fkoran/fkoran.github.io/README.md

# [fkoran.github.io](https://fkoran.github.io/)
