fkoran/fkoran.github.io/_posts/2016-09-06-ergodox.markdown

---
layout: post
title: Ergodox Build
---

{::comment}
Need photos for:
- keyswitch layout inc. edges with ambiguous orientation
- finished product
- shot of the tools
- pcb, layer 3, and switches alone
- format tables, generate small images
{:/comment}

{::comment}
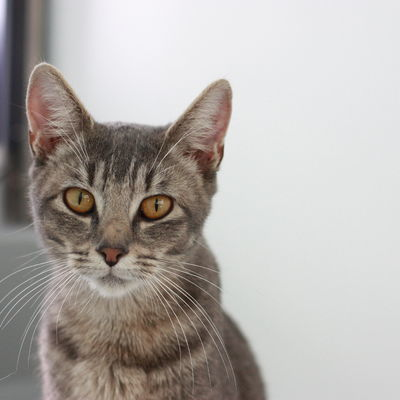
[picture p1: images/ergodox/beauty_small.jpg]
[](/images/ergodox/beauty.jpg)
{:/comment}

[Parts](#parts-list) |
[Case](#case) |
[Assembly](#assembly-instructions) |
[Troubleshooting](#troubleshooting) |
[3D Printing](#d-printing)

# Parts List

I purchased parts on DigiKey per the [ergodox.org]( http://ergodox.org ) list, which I'll reproduce here since that site is currently offline

{::comment}
| Ergodox PCB 							| [mechanicalkeyboards.com]( https://mechanicalkeyboards.com/shop/index.php?l=product_detail&p=537 ) 			|									|
| Teesny 2.0 with headers 					| [mechanicalkeyboards.com]( https://mechanicalkeyboards.com/shop/index.php?l=product_detail&p=568 ) 			|									|
| 10x Gateron Brown Keyswitch - Plate Mount - Pack of 10	| [mechanicalkeyboards.com]( https://mechanicalkeyboards.com/shop/index.php?l=product_detail&p=1640 ) 			|									|
| DSA Keycaps - Ergodox Base Set and Ergodox Modifier Set 	| [pimpmykeyboard.com]( http://pimpmykeyboard.com/dsa-pbt-abs-blank-keycap-sets/ ) 					|									|
| 4 Conductor 3.5mm TRRS Audio Cable 				| [amazon]( http://amzn.to/2cAZh8s )											|									|
| CP-43514 4 Conductor 3.5mm TRRS Audio Jack 			| [digikey]( http://www.digikey.com/product-detail/en/cui-inc/SJ-43514/CP-43514-ND/368146 )				|									|
| WM17115-ND USB Mini-B Receptacle 				| [digikey]( http://www.digikey.com/product-detail/en/molex-llc/0548190519/WM17115-ND/773802 ) 				| **often out of stock** 						|
| MCP23018 IO Expander 						| [digikey]( http://www.digikey.com/product-detail/en/microchip-technology/MCP23018-E-SP/MCP23018-E-SP-ND/1999505 )	|									|
| 0.1uF Through-hole Ceramic Capacitor 				| [digikey]( http://www.digikey.com/product-detail/en/vishay-bc-components/K104K10X7RF5UH5/BC2665CT-ND/2356879 ) 	|									|
| 2x 2.2kΩ Through-hole Resistor 				| [digikey]( http://www.digikey.com/product-detail/en/yageo/CFR-25JB-52-2K2/2.2KQBK-ND/666 ) 				|									|
| 4x 220Ω Through-hole Resistor 				| [digikey]( http://www.digikey.com/product-detail/en/yageo/CFR-25JB-52-220R/220QBK-ND/1295 ) 				|									|
| <strike>100x Axial Through-hole Diode 			| [digikey]( http://www.digikey.com/product-detail/en/fairchild-semiconductor/1N4148/1N4148FS-ND/458603 )</strike> 	| **recommend substituting the surface mount diodes listed below:**	|
| 100x SOT123 Surface Mount Diode 				| [digikey]( http://www.digikey.com/product-detail/en/diodes-incorporated/1N4148W-7-F/1N4148W-FDICT-ND/815280 ) 	|									|
| *3mm Green LED 						| [digikey]( http://www.digikey.com/product-detail/en/lite-on-inc/LTL-4236N/160-1144-ND/214443 ) (optional)* 		|									|
| *3mm Yellow LED 						| [digikey]( http://www.digikey.com/product-detail/en/lite-on-inc/LTL-4256N/160-1147-ND/151820 ) (optional)* 		|									|
| *3mm Red LED 							| [digikey]( http://www.digikey.com/product-detail/en/lite-on-inc/LTL-4266N/160-1034-ND/121770 ) (optional)* 		|									|
{:/comment}

- [Ergodox PCB]( https://mechanicalkeyboards.com/shop/index.php?l=product_detail&p=537 )
- [Teesny 2.0 with headers]( https://mechanicalkeyboards.com/shop/index.php?l=product_detail&p=568 )
- [10x Gateron Brown Keyswitch - Plate Mount - Pack of 10]( https://mechanicalkeyboards.com/shop/index.php?l=product_detail&p=1640 )
- [DSA Keycaps - Ergodox Base Set and Ergodox Modifier Set]( http://pimpmykeyboard.com/dsa-pbt-abs-blank-keycap-sets/ )
- [4 Conductor 3.5mm TRRS Audio Cable]( http://amzn.to/2cAZh8s )
- [CP-43514 4 Conductor 3.5mm TRRS Audio Jack]( http://www.digikey.com/product-detail/en/cui-inc/SJ-43514/CP-43514-ND/368146 )
- [WM17115-ND USB Mini-B Receptacle]( http://www.digikey.com/product-detail/en/molex-llc/0548190519/WM17115-ND/773802 ) - **often out of stock**
- [MCP23018 IO Expander]( http://www.digikey.com/product-detail/en/microchip-technology/MCP23018-E-SP/MCP23018-E-SP-ND/1999505 )
- [0.1uF Through-hole Ceramic Capacitor]( http://www.digikey.com/product-detail/en/vishay-bc-components/K104K10X7RF5UH5/BC2665CT-ND/2356879 )
- [2x 2.2kΩ Through-hole Resistor]( http://www.digikey.com/product-detail/en/yageo/CFR-25JB-52-2K2/2.2KQBK-ND/666 )
- [4x 220Ω Through-hole Resistor]( http://www.digikey.com/product-detail/en/yageo/CFR-25JB-52-220R/220QBK-ND/1295 )
- [<strike>100x Axial Through-hole Diode</strike>]( http://www.digikey.com/product-detail/en/fairchild-semiconductor/1N4148/1N4148FS-ND/458603 ) - **recommend substituting the surface mount diodes listed below:**
- [100x SOT123 Surface Mount Diode ]( http://www.digikey.com/product-detail/en/diodes-incorporated/1N4148W-7-F/1N4148W-FDICT-ND/815280 )
- [3mm Green LED]( http://www.digikey.com/product-detail/en/lite-on-inc/LTL-4236N/160-1144-ND/214443 ) - **optional**
- [3mm Yellow LED ]( http://www.digikey.com/product-detail/en/lite-on-inc/LTL-4256N/160-1147-ND/151820 ) - **optional**
- [3mm Red LED ]( http://www.digikey.com/product-detail/en/lite-on-inc/LTL-4266N/160-1034-ND/121770 ) - **optional**

{::comment}
<table>
<tr>
 <td>Ergodox PCB</td>
 <td>[mechanicalkeyboards.com]( https://mechanicalkeyboards.com/shop/index.php?l=product_detail&p=537 )/td>
 <td>/td>
</tr>
<tr>
 <td>Teesny 2.0 with headers/td>
 <td>[mechanicalkeyboards.com]( https://mechanicalkeyboards.com/shop/index.php?l=product_detail&p=568 )/td>
 <td>/td>
</tr>
<tr>
 <td>10x Gateron Brown Keyswitch - Plate Mount - Pack of 10/td>
 <td>[mechanicalkeyboards.com]( https://mechanicalkeyboards.com/shop/index.php?l=product_detail&p=1640 )/td>
 <td>/td>
</tr>
<tr>
 <td>DSA Keycaps - Ergodox Base Set and Ergodox Modifier Set/td>
 <td>[pimpmykeyboard.com]( http://pimpmykeyboard.com/dsa-pbt-abs-blank-keycap-sets/ )/td>
 <td>/td>
</tr>
<tr>
 <td>4 Conductor 3.5mm TRRS Audio Cable/td>
 <td>[amazon]( http://amzn.to/2cAZh8s )/td>
 <td>/td>
</tr>
<tr>
 <td>CP-43514 4 Conductor 3.5mm TRRS Audio Jack/td>
 <td>[digikey]( http://www.digikey.com/product-detail/en/cui-inc/SJ-43514/CP-43514-ND/368146 )/td>
 <td>/td>
</tr>
<tr>
 <td>WM17115-ND USB Mini-B Receptacle/td>
 <td>[digikey]( http://www.digikey.com/product-detail/en/molex-llc/0548190519/WM17115-ND/773802 )/td>
 <td>**often out of stock**/td>
</tr>
<tr>
 <td>MCP23018 IO Expander/td>
 <td>[digikey]( http://www.digikey.com/product-detail/en/microchip-technology/MCP23018-E-SP/MCP23018-E-SP-ND/1999505 )/td>
 <td>/td>
</tr>
<tr>
 <td>0.1uF Through-hole Ceramic Capacitor/td>
 <td>[digikey]( http://www.digikey.com/product-detail/en/vishay-bc-components/K104K10X7RF5UH5/BC2665CT-ND/2356879 )/td>
 <td>/td>
</tr>
<tr>
 <td>2x 2.2kΩ Through-hole Resistor</td>
 <td>[digikey]( http://www.digikey.com/product-detail/en/yageo/CFR-25JB-52-2K2/2.2KQBK-ND/666 )</td>
 <td></td>
</tr>
<tr>
 <td>4x 220Ω Through-hole Resistor</td>
 <td>[digikey]( http://www.digikey.com/product-detail/en/yageo/CFR-25JB-52-220R/220QBK-ND/1295 )</td>
 <td></td>
</tr>
<tr>
 <td><strike>100x Axial Through-hole Diode</td>
 <td>[digikey]( http://www.digikey.com/product-detail/en/fairchild-semiconductor/1N4148/1N4148FS-ND/458603 )</strike></td>
 <td>**recommend substituting the surface mount diodes listed below:**</td>
</tr>
<<tr>
 <td>100x SOT123 Surface Mount Diode</td>
 <td>[digikey]( http://www.digikey.com/product-detail/en/diodes-incorporated/1N4148W-7-F/1N4148W-FDICT-ND/815280 )</td>
 <td></td>
</tr>
<tr>
 <td>*3mm Green LED</td>
 <td>[digikey]( http://www.digikey.com/product-detail/en/lite-on-inc/LTL-4236N/160-1144-ND/214443 )</td>
 <td>(optional)*</td>
</tr>
<tr>
 <td>*3mm Yellow LED</td>
 <td>[digikey]( http://www.digikey.com/product-detail/en/lite-on-inc/LTL-4256N/160-1147-ND/151820 )</td>
 <td>(optional)*</td>
</tr>
<tr>
 <td>*3mm Red LED</td>
 <td>[digikey]( http://www.digikey.com/product-detail/en/lite-on-inc/LTL-4266N/160-1034-ND/121770 )</td>
 <td>(optional)*</td>
</tr>
</table>
{:/comment}

If I were building this again I would substitute surface mount parts in place of the through hole diodes. They're easier to solder and trim and will result in a cleaner final product with wider mechanical clearances. Be aware that the mini-USB B connecter often goes out of stock.

I chose to use Gateron Brown switches. They seem widely regarded as a better quality clone of the gold standard Cherry MX brand and have a [light, tactile throw](http://www.wasdkeyboards.com/mechanical-keyboard-guide#best) without being clicky.

Note that a standard, stereo audio cable isn't enough to connect the two sides. You need a four conductor TRRS cable (the extra aRRRR is for tip-ring-ring-sleeve) to carry GND, +5, and I²C SDA/SCL.

There are a couple standard keycap profiles. DSA is convenient because keys are [interchangable]( http://pimpmykeyboard.com/key-cap-family-specs/) between rows. This was especially desirable because I planned to use the [Colemak]( http://chetansurpur.com/blog/2012/11/colemak.html ) layout, for which profiled keycaps would be hard to find

# Case

I pulled what appear to be Litster's original .DXF files from [bishboria's github]( https://github.com/bishboria/ErgoDox/tree/master/ErgoDox%20Acrylic%20Case ) and exported them to SVG using Inkscape.

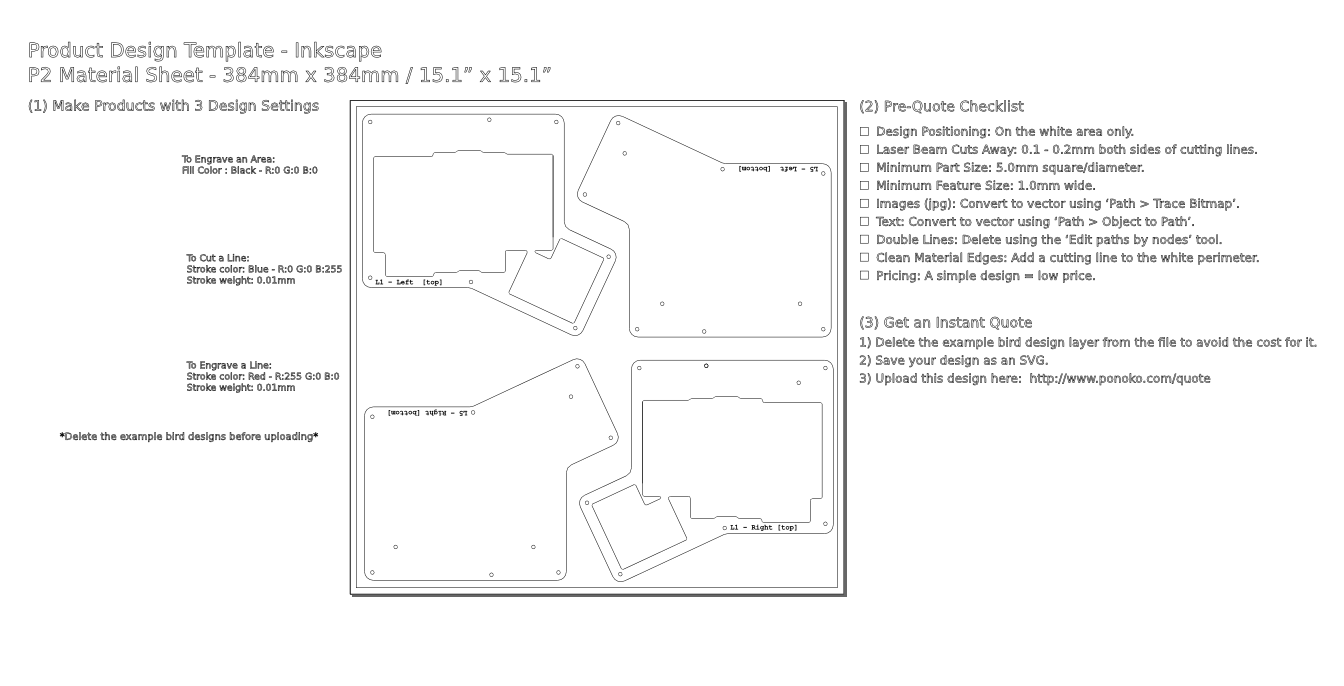
[picture p2: images/ergodox/ponoko.png]
[](/images/ergodox/ponoko.png)

I had the files laser cut from acrylic at [Ponoko]( https://www.ponoko.com/ ). I made a mistake scaling one of the spacer layers in the process of tiling the SVGs onto a single panel, so I had to substitute a set of washers until I was able to print a [replacement](#d-printing).

The SVGs are up on [my github]( https://github.com/fkoran/ergodox-acrylic-svg ).

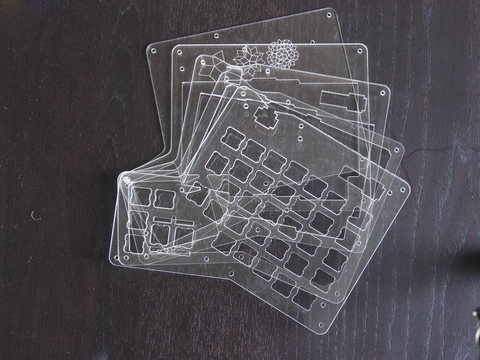
[picture p3: images/ergodox/layer_all_left_small.jpg]
[](/images/ergodox/layer_all_left.jpg)

These are the layer thicknesses I used. The Gateron switches fit perfectly with 4.5mm acrylic on layer 3. Be sure if you're using THT diodes that layer 4 is a bit thicker than 4.5mm.

- Top - 3mm
- Spacer - 4.5mm
- Switch plate - 4.5mm
- Spacer - 4.5mm
- Bottom - 3mm

# Assembly Instructions

I used the [Massdrop](https://keyboard-configurator.massdrop.com/ext/ergodox/assembly.php) assembly instructions as a reference. If this is your first soldering project it's worth flipping through the [Soldering is Easy (8 page pdf)]( https://mightyohm.com/files/soldercomic/FullSolderComic_EN.pdf )

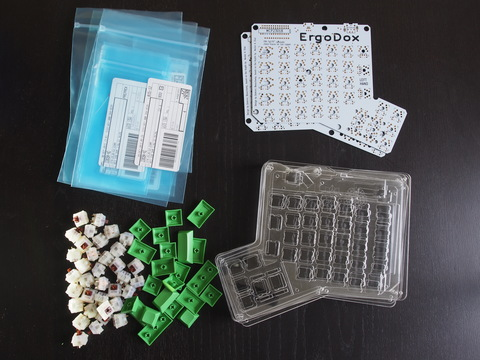
[picture p4: images/ergodox/parts_pcb_acrylic_keys_caps_small.jpg]
[](/images/ergodox/parts_pcb_acrylic_keys_caps.jpg)

## Tools

{::comment}
[](/images/ergodox/null.jpg)
{:/comment}

- [Digitally temperature regulated soldering iron]( http://amzn.to/2cAUvrr )
- [Solder]( http://amzn.to/2cAXe47 )
- [Tweezers]( http://amzn.to/2cAV9Wb )
- [Helping hand ]( http://amzn.to/2cAUfJ2 ) or [multi-purpose hobby vise]( http://amzn.to/2cAUzHW )
- [20-30 gauge wire stripping tool]( http://amzn.to/2cAV84l )
- [Flush cut wire trimmers]( http://amzn.to/2cATtvy )

## For THT diodes

Bend each diode into a U shape and populate the marked spaces below each of the keyswitch sockets

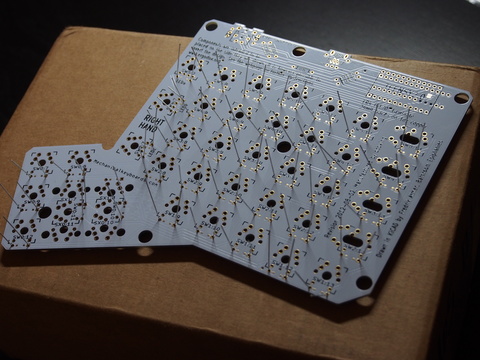
[picture p5: images/ergodox/assembly_diodes_sharp_side_small.jpg]
[](/images/ergodox/assembly_diodes_sharp_side.jpg)

Confirm that each diode is oriented so that the cathode, marked with a black ring, is closer to the square solder pad

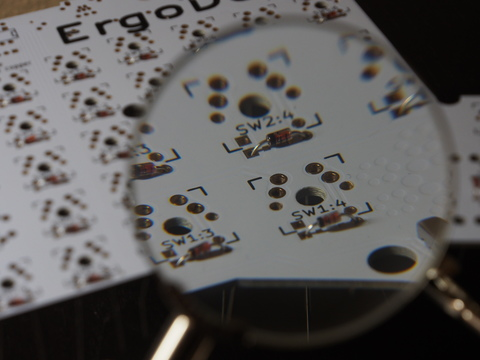
[picture p6: images/ergodox/assembly_diodes_magnified_small.jpg]
[](/images/ergodox/assembly_diodes_magnified.jpg)

Clip the leads with a pair of flush cut trimmers and press the diode bodies flat against the PCB

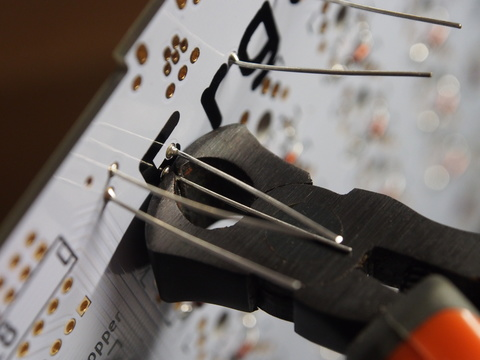
[picture p7: images/ergodox/assembly_diode_clip_small.jpg]
[](/images/ergodox/assembly_diode_clip.jpg)

{::comment}
[](/images/ergodox/null.jpg)
{:/comment}

## For SMT diodes

Solder a diode below each of the keyswitch sockets. Confirm that each diode is oriented so that the cathode, marked with a white line, is closer to the square solder pad

[https://learn.sparkfun.com/tutorials/polarity/diode-and-led-polarity](https://learn.sparkfun.com/tutorials/polarity/diode-and-led-polarity)

## Resistors

The resistors are color coded. (relevant [xkcd]( https://xkcd.com/227/ ))

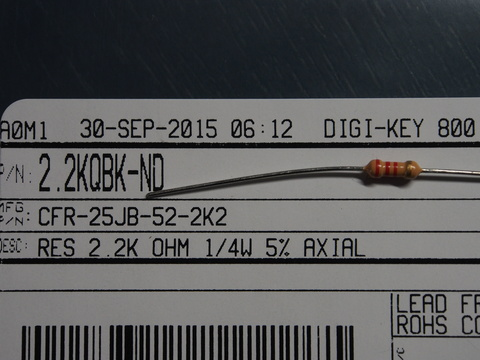
[picture p8: images/ergodox/parts_resistor_2_2k_small.jpg]
[](/images/ergodox/parts_resistor_2_2k.jpg)
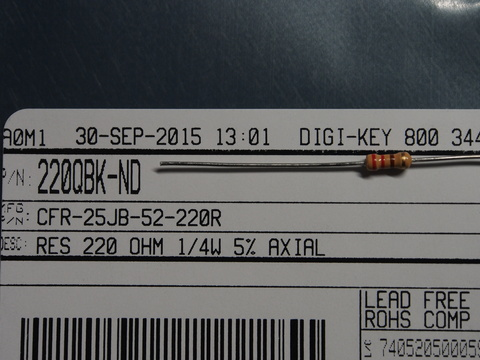
[picture p9: images/ergodox/parts_resistor_220ohm_small.jpg]
[](/images/ergodox/parts_resistor_220ohm.jpg)

## TRRS Connector (3.5mm audio jack)

Populate the jumpers as shown. These are needed to reuse the same PCB for left and right hands

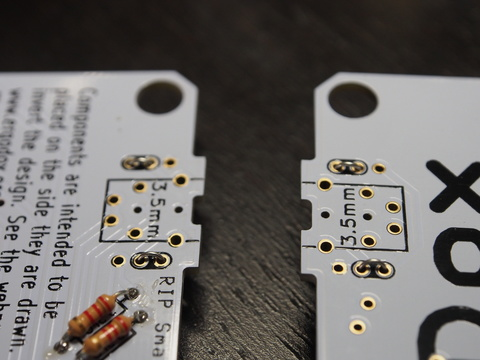
[picture p10: images/ergodox/assembly_trrs_jumpers_stuffed_small.jpg]
[](/images/ergodox/assembly_trrs_jumpers_stuffed.jpg)

## IO Expander

Populate the IO expander DIP as shown

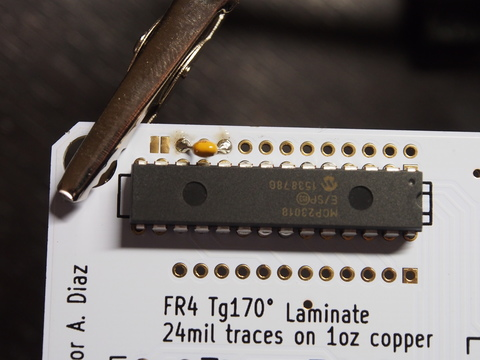
[picture p11: images/ergodox/assembly_mcu_cap_small.jpg]
[](/images/ergodox/assembly_mcu_cap.jpg)

## Teensy

Cut and strip the spare USB mini-B cable to bridge from the PCB to the Teensy

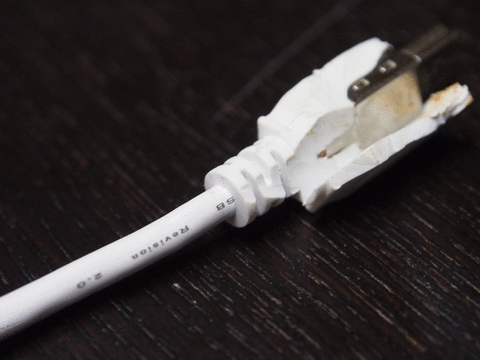
[picture p12: images/ergodox/assembly_usb_cut_alt.gif]
[](/images/ergodox/assembly_usb_cut_alt.gif)

Plug the 12 pin inline headers into the right hand PCB and stack the Teesny 2.0 on top of them. Tack down two pins on opposing corners to hold the assembly in place before soldering the rest

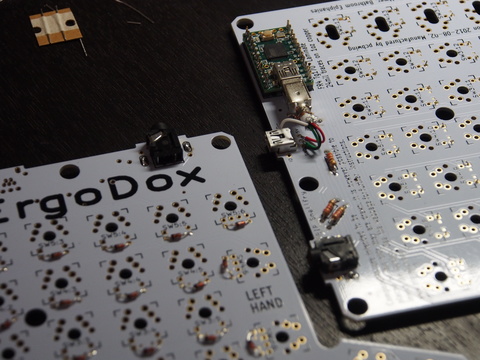
[picture p13: images/ergodox/assembly_complete_minus_keys_small.jpg]
[](/images/ergodox/assembly_complete_minus_keys.jpg)

## Keyswitches

Plug the keyswitches into the layer 3 support plate. Place the support plate switch-side down on a table and align the PCB with the switch pins. Solder the switches down while the support plate is sandwiched between the keyswitches and the PCB.

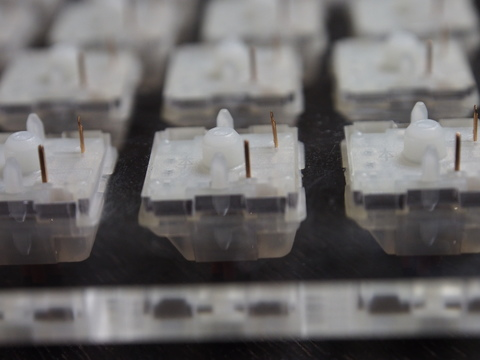
[picture p14: images/ergodox/assembly_switches_alt_small.jpg]
[](/images/ergodox/assembly_switches_alt.jpg)

# Troubleshooting

The left side of the keyboard worked perfectly on the first try. As soon as I plugged in the right side my laptop started opening the Win+X menu. 

I rebuilt the [firmware]( https://github.com/benblazak/ergodox-firmware ) to generate a 'z' from what had been the windows key and got a spray of "bzzxcvbzzxcvbzzxcvbzzxcvbzzxcvbzzxcvb"

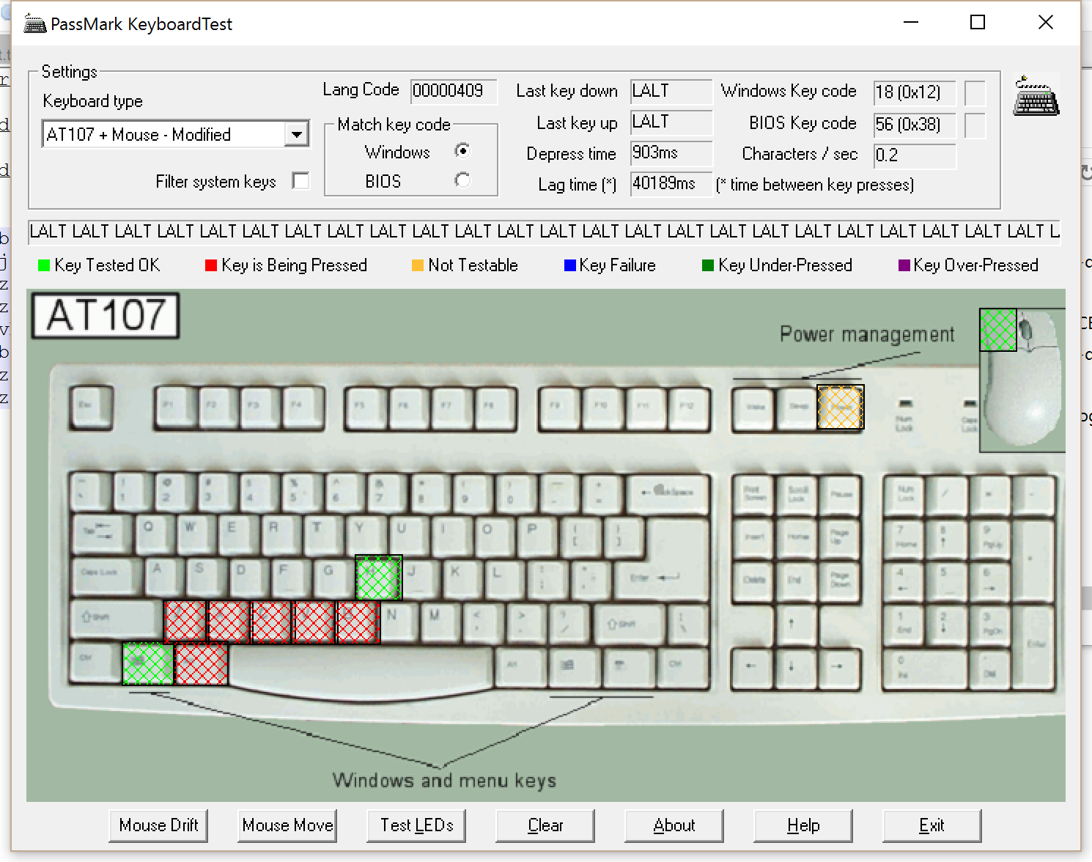
[picture p15: images/ergodox/troubleshoot_keytest.png]
[](/images/ergodox/troubleshoot_keytest.png)

After a quick visual inspection to verify that the diodes were all oriented correctly, I brought up the [board file]( https://github.com/bishboria/ErgoDox/tree/master/ErgoDOX%20pcb )

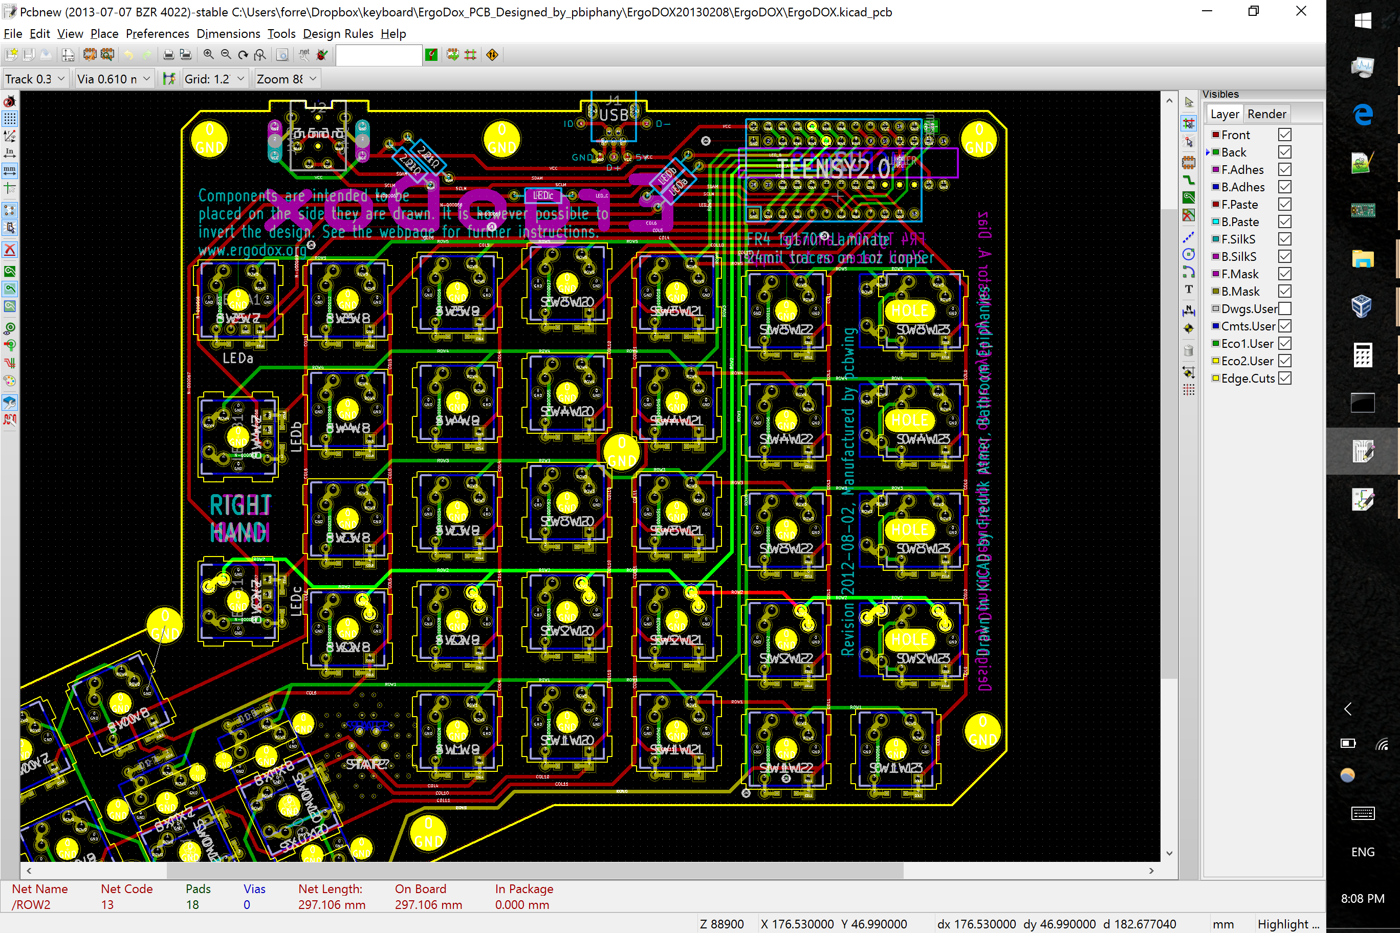
[picture p16: images/ergodox/troubleshoot_schematic.png]
[](/images/ergodox/troubleshoot_schematic.png)

When the firmware performs a scan it pulls each column low in turn. While a given column is low it checks each row to see if a closed switch is connecting the two. Komar has a good overview of this on his [site](http://blog.komar.be/how-to-make-a-keyboard-the-matrix/). All the affected keys were on the ROW2 net.

Since each row net surfaces only at the IO expander and at the switches of that row, I had only to check for shorts at those points. The culprit was a solder bridge between a switch and an adjacent mounting hole.

# 3D Printing

I was able to get an extra layer printed in PLA at PSU's [LID Lab](http://psu-epl.github.io/). I used Landa's [svg2stl](http://svg2stl.com/) to rasterize and extrude the flat SVG to an STL file. To reduce print time I removed the ceiling and floor, exposing an attractive honeycomb fill pattern.

[](/images/ergodox/honeycomb.jpg)

{::comment}

# Conclusion

[](/images/ergodox/finished.jpg)

{:/comment}
