fkoran/fkoran.github.io/_posts/2016-09-04-inkscape-fill-path-direction.markdown

---
layout: post
title: Inkscape - How to display path direction
---

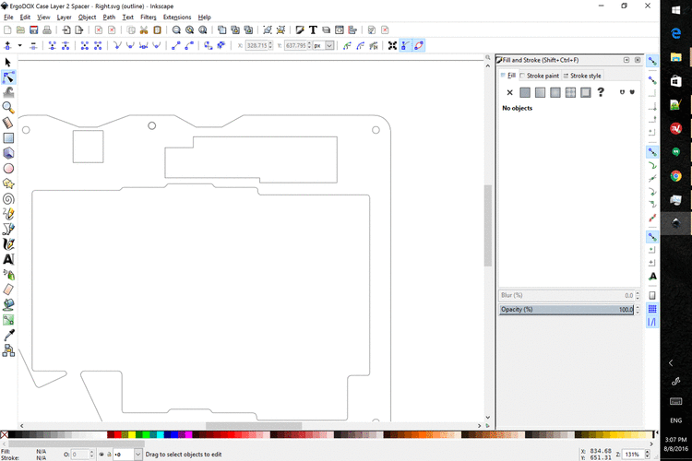
[picture p18: images/inkscape-path/path_small.gif]
[](/images/inkscape-path/path.gif)

By default, Inkscape doesn't show tick marks to indicate the direction of a path. There's an option to turn those on.

This is useful when using the node tool to set path direction in preperation to set fill-rule: even-odd or nonzero. 

Animated walkthrough to the right, click to enlarge.
