fkoran/fkoran.github.io/images/ergodox/diode_macro (2)_small.jpg

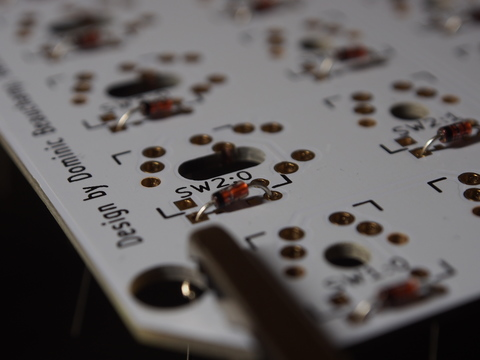
images/ergodox/diode_macro (2)_small.jpg
