fkoran/fkoran.github.io/images/ergodox/diode_macro (3).jpg

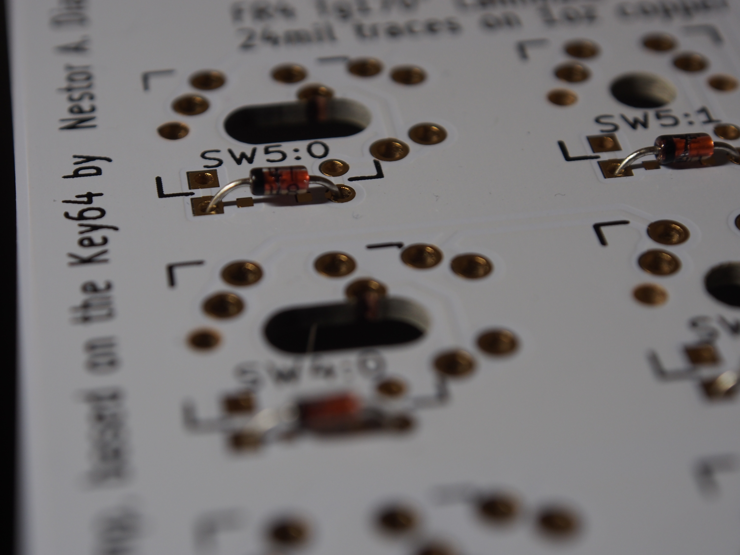
images/ergodox/diode_macro (3).jpg
