fkoran/fkoran.github.io/images/ergodox/diode_macro_small.jpg

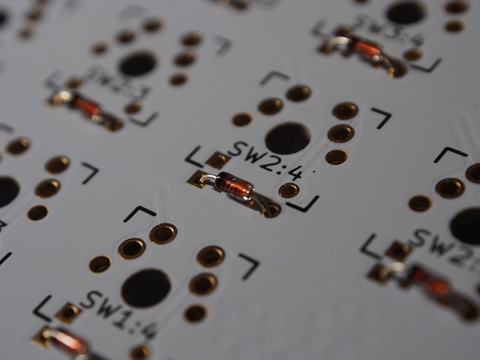
images/ergodox/diode_macro_small.jpg
