fkoran/fkoran.github.io/images/ergodox/layer_l2_spacer_left.jpg

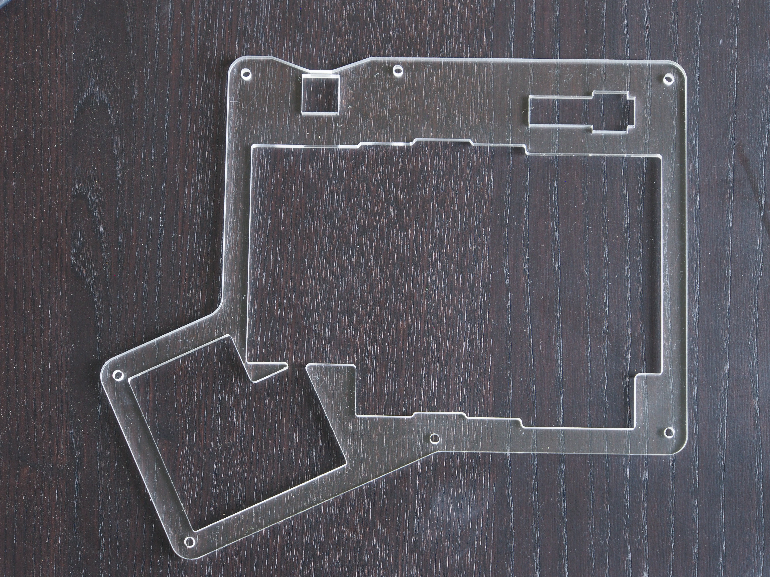
images/ergodox/layer_l2_spacer_left.jpg
