fkoran/fkoran.github.io/images/ergodox/layer_l2_spacer_right_broken_w_l2_left.jpg

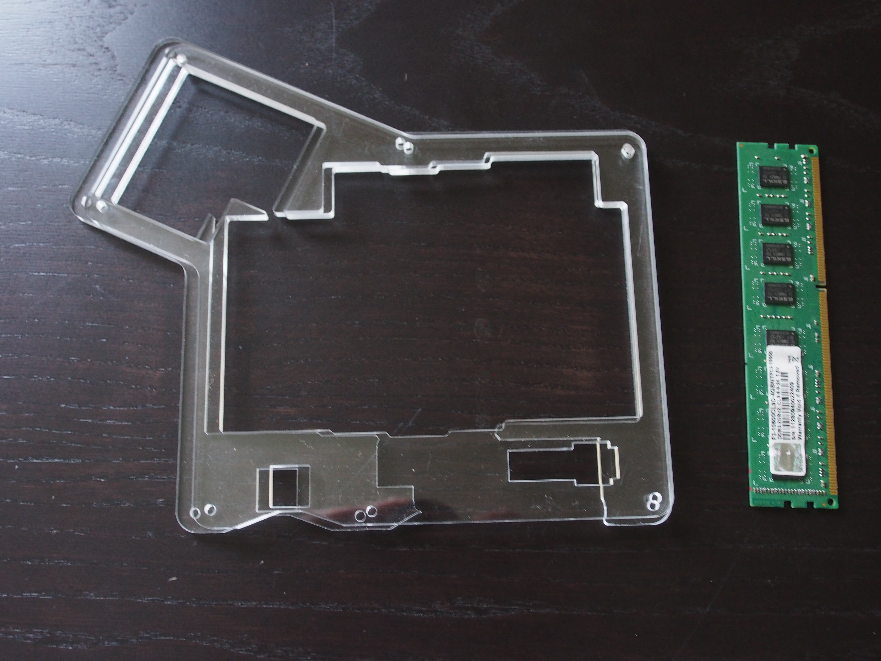
images/ergodox/layer_l2_spacer_right_broken_w_l2_left.jpg
