fkoran/fkoran.github.io/images/ergodox/layer_l2_spacer_right_broken_w_l3_right.jpg

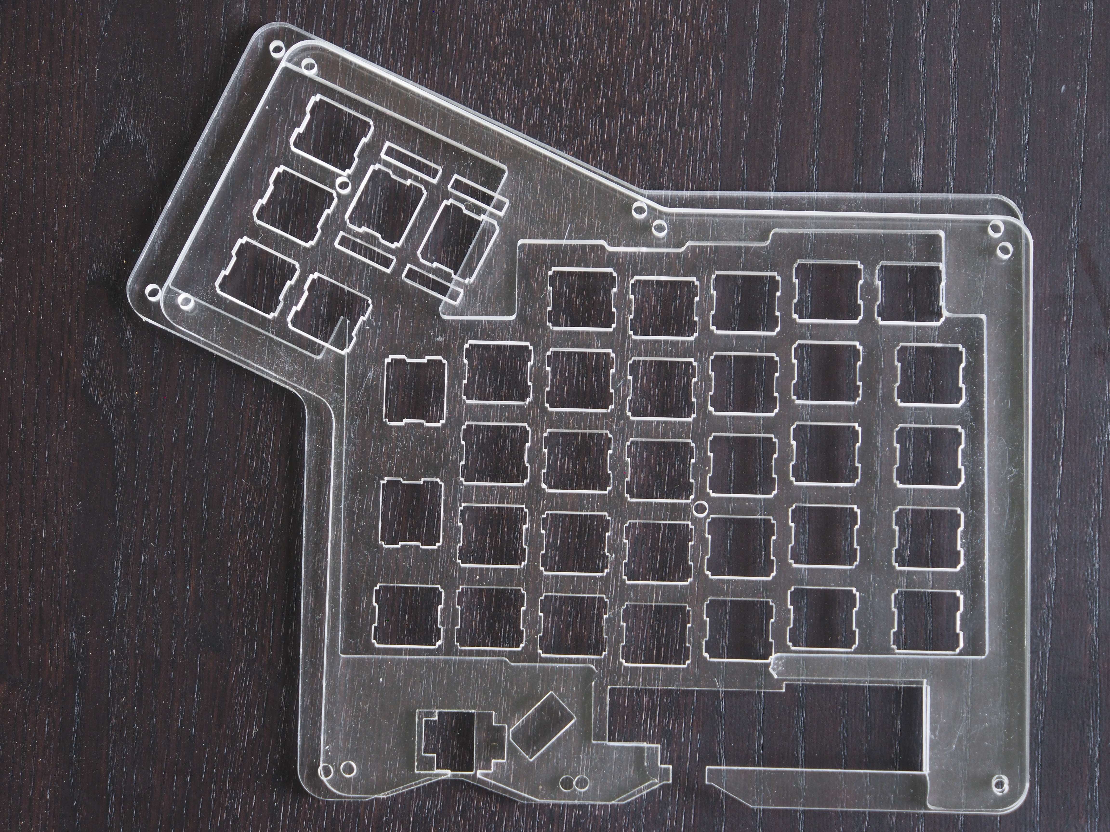
images/ergodox/layer_l2_spacer_right_broken_w_l3_right.jpg
