fkoran/fkoran.github.io/images/ergodox/layer_l3_plate_left.jpg

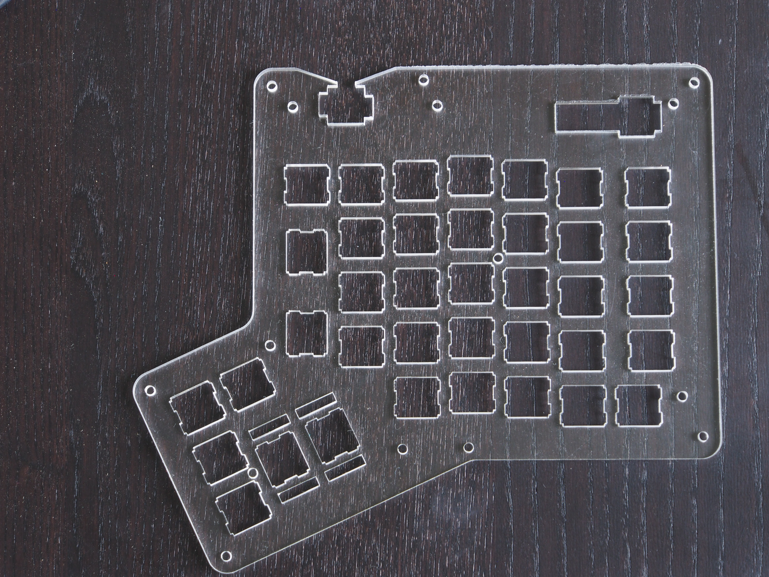
images/ergodox/layer_l3_plate_left.jpg
