fkoran/fkoran.github.io/images/ergodox/tools_clamp_magnifier.jpg

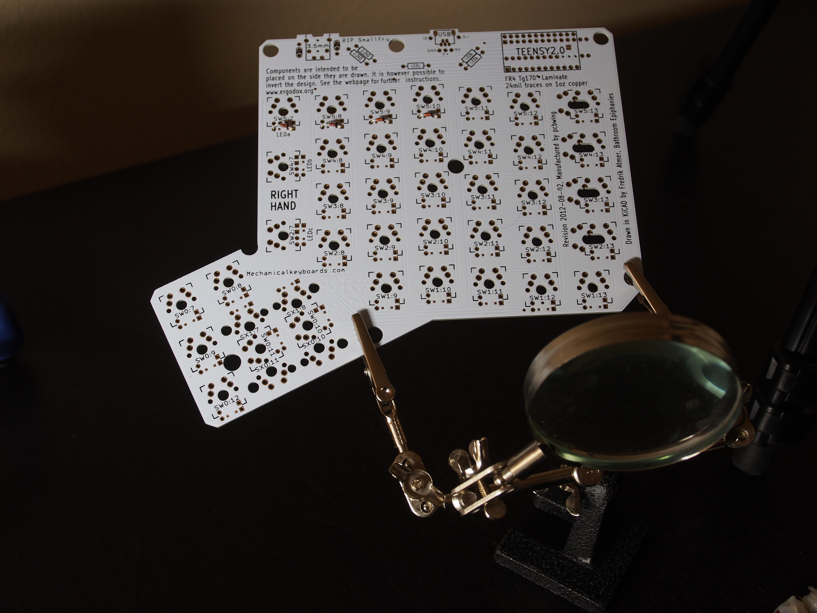
images/ergodox/tools_clamp_magnifier.jpg
