fkoran/fkoran.github.io/images/inkscape-path/2.png

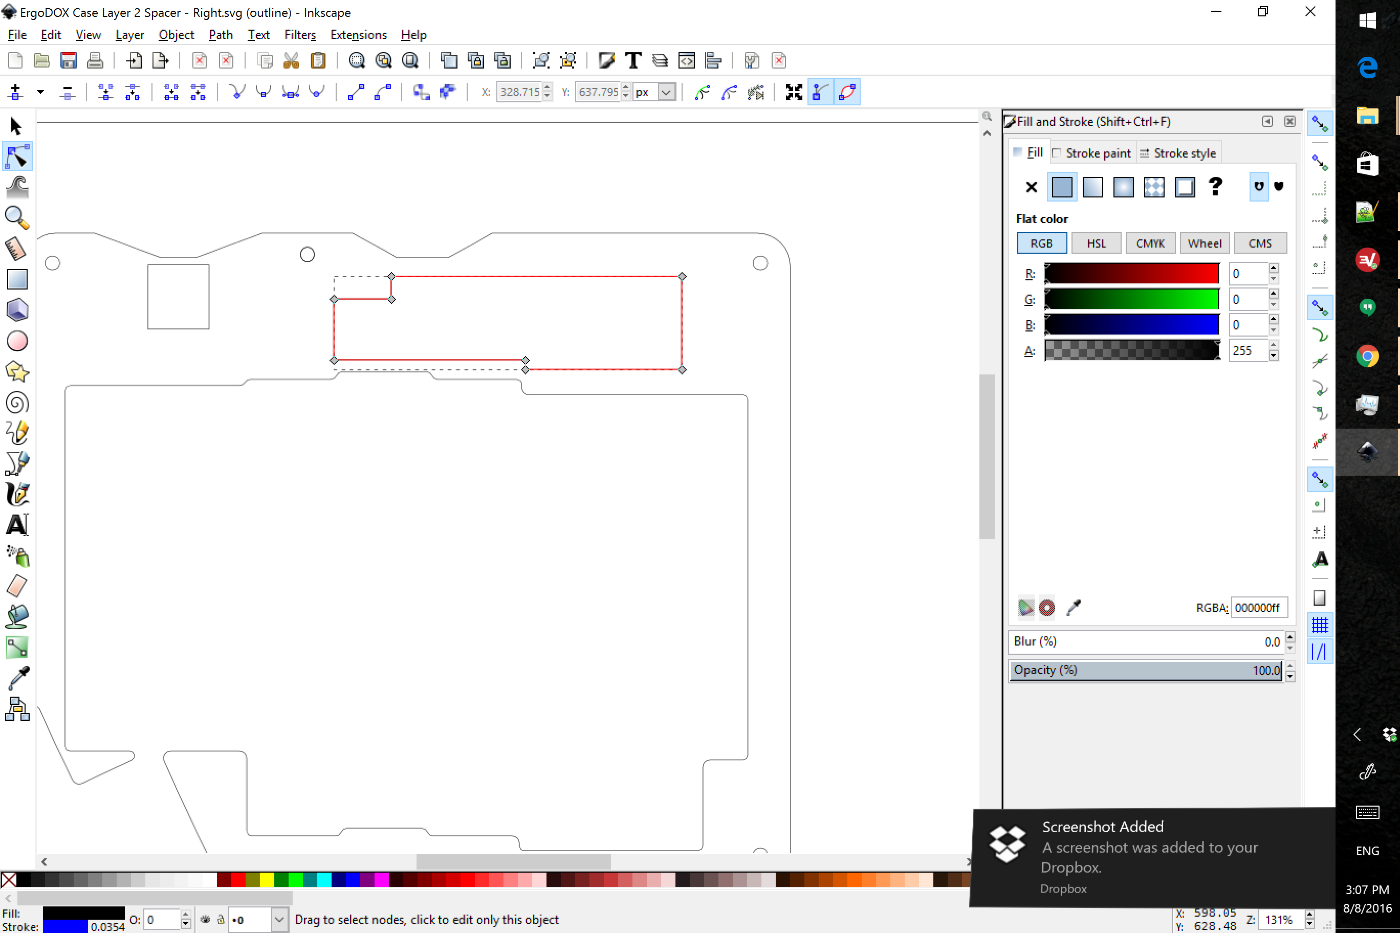
images/inkscape-path/2.png
