fkoran/fkoran.github.io/images/inkscape-path/3.png

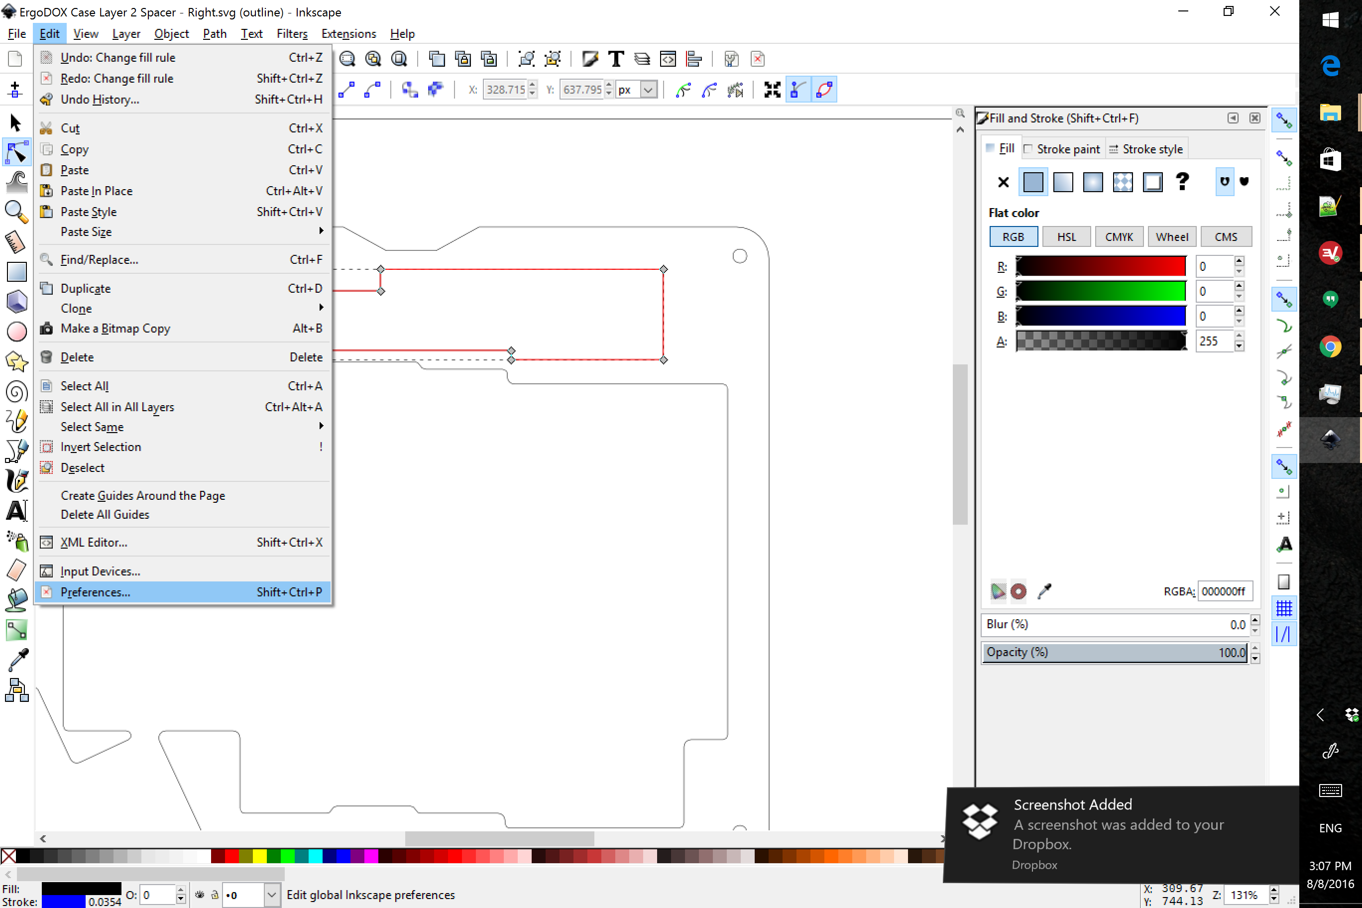
images/inkscape-path/3.png
