fkoran/fkoran.github.io/images/inkscape-path/4.png

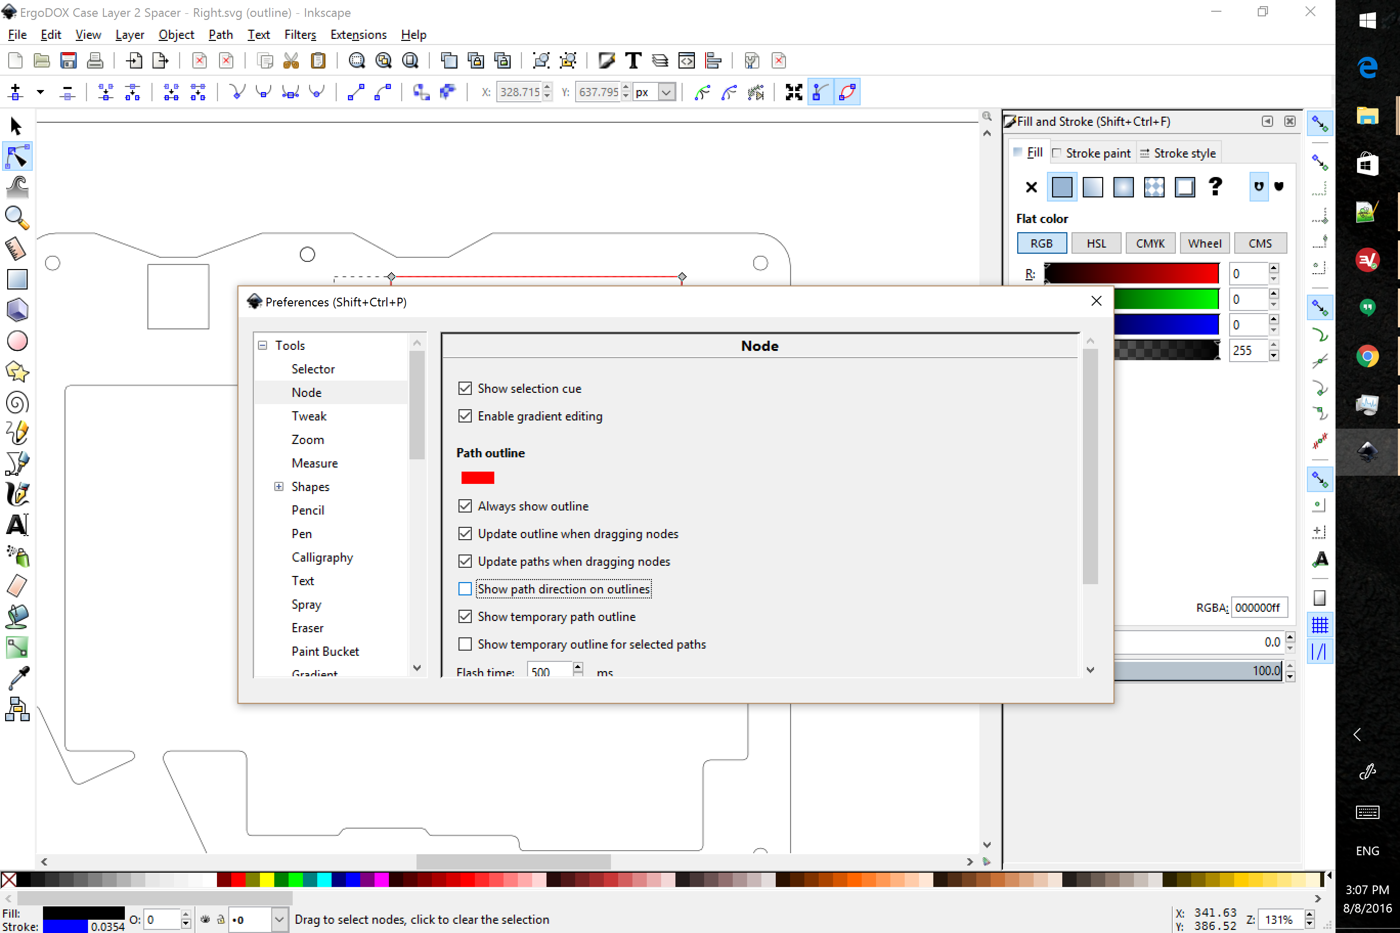
images/inkscape-path/4.png
