fkoran/fkoran.github.io/images/inkscape-path/filled.png

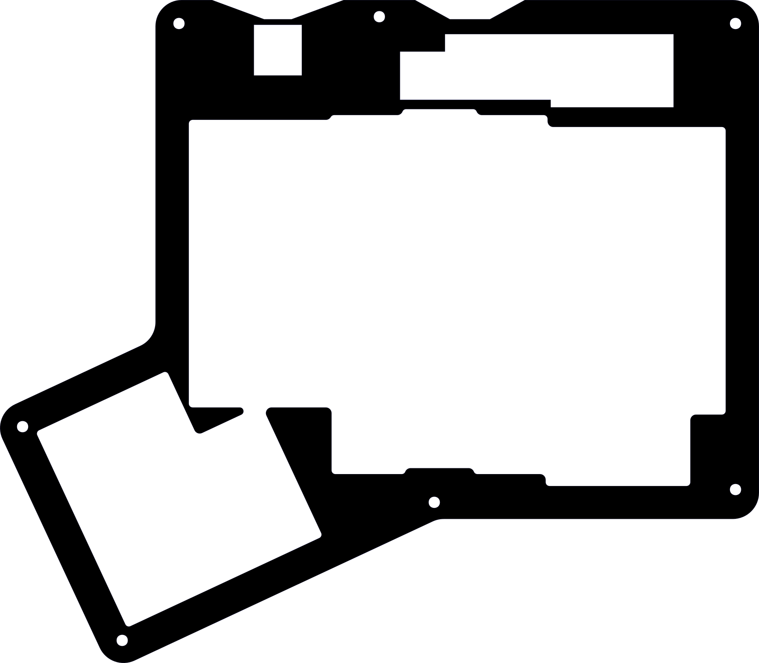
images/inkscape-path/filled.png
