fkoran/fkoran.github.io/images/ergodox/parts_diodes.jpg

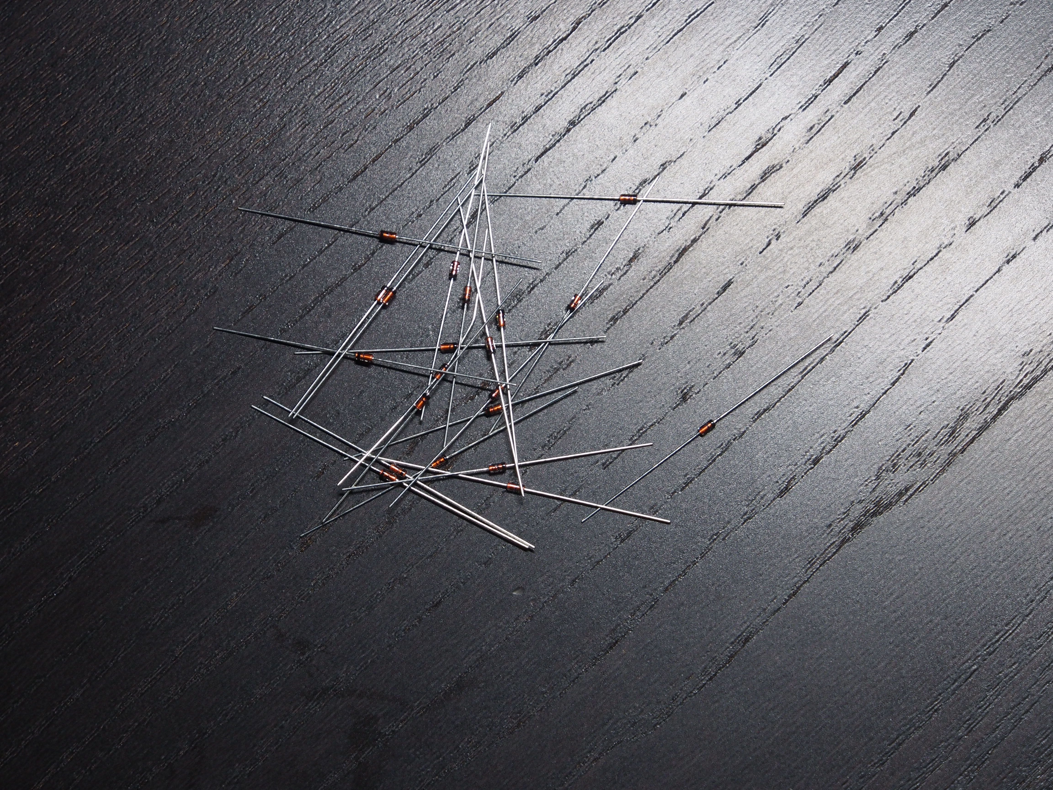
images/ergodox/parts_diodes.jpg
