fkoran/fkoran.github.io/images/ergodox/parts_teensy_small.jpg

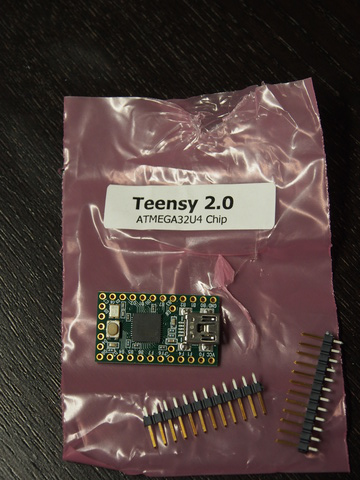
images/ergodox/parts_teensy_small.jpg
