fkoran/fkoran.github.io/keyboard/files/Ergodox/ErgoDOX Acrylic Case - Designed by Litster/with Wrist Rest/Right/ErgoDOX Wrist Rest Case Layer 3 Plate - Right.dxf

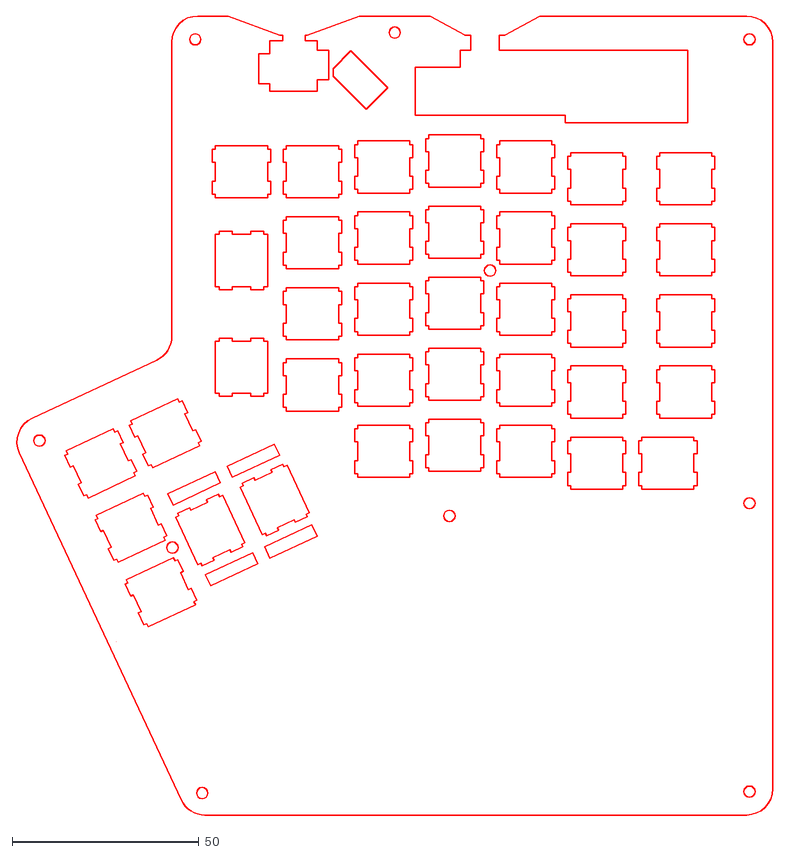
[picture p36: CAD file, 2016-09-06, last stored version]
keyboard/files/Ergodox/ErgoDOX Acrylic Case - Designed by Litster/with Wrist Rest/Right/ErgoDOX Wrist Rest Case Layer 3 Plate - Right.dxf
202.8 x 214.1
