fkoran/fkoran.github.io/keyboard/files/Ergodox/Extrusion/ErgoDOX Case Layer 2 Spacer - Right - filled.svg_5mm.stl

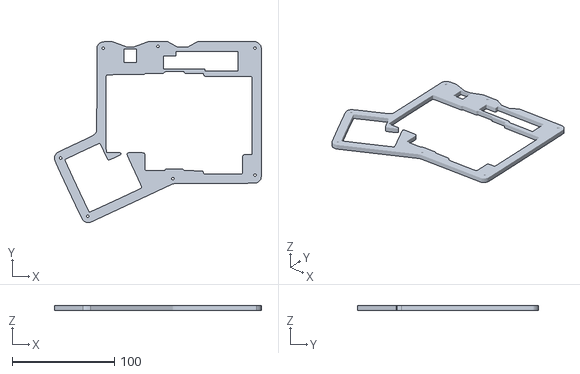
[picture p37: CAD file, 2016-09-06, last stored version]
keyboard/files/Ergodox/Extrusion/ErgoDOX Case Layer 2 Spacer - Right - filled.svg_5mm.stl
202.8 x 177.1 x 5.00
