fkoran/fkoran.github.io/keyboard/files/Ergodox/ErgoDOX Acrylic Case - Designed by Litster/with Wrist Rest/Left/test cut.dxf

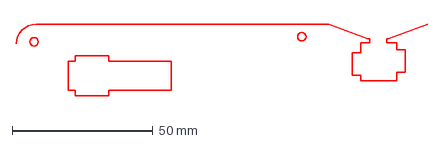
[picture p40: CAD file, 2016-09-06, last stored version]
keyboard/files/Ergodox/ErgoDOX Acrylic Case - Designed by Litster/with Wrist Rest/Left/test cut.dxf
146.0 x 25.5 mm
