fkoran/fkoran.github.io/keyboard/files/Ergodox/Extrusion/fragments.svg_5mm.stl

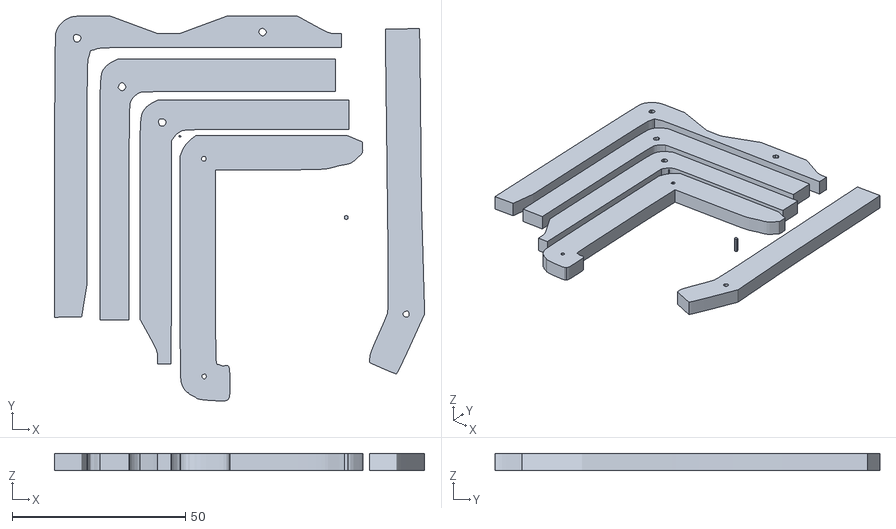
[picture p42: CAD file, 2016-09-06, last stored version]
keyboard/files/Ergodox/Extrusion/fragments.svg_5mm.stl
106.9 x 111.1 x 5.00
