fkoran/fkoran.github.io/keyboard/files/Ergodox/ErgoDOX Acrylic Case - Designed by Litster/Standard/Left/ErgoDOX Case Layer 4 Spacer - Left.dxf

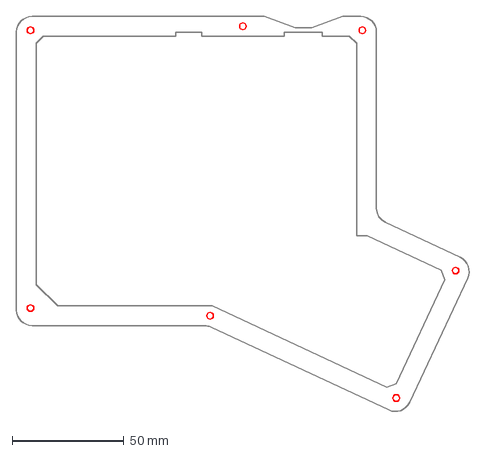
[picture p43: CAD file, 2016-09-06, last stored version]
keyboard/files/Ergodox/ErgoDOX Acrylic Case - Designed by Litster/Standard/Left/ErgoDOX Case Layer 4 Spacer - Left.dxf
202.8 x 177.8 mm
