fkoran/fkoran.github.io/keyboard/files/Ergodox/ErgoDOX Acrylic Case - Designed by Litster/Standard/Left/ErgoDOX Case Layer 2 Spacer - Left.dxf

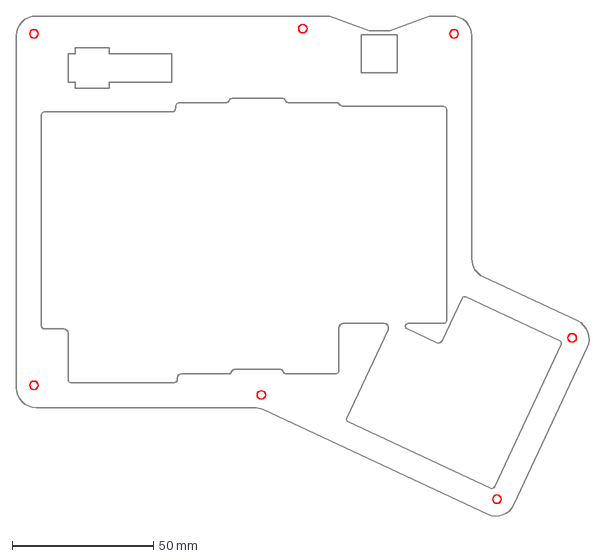
[picture p47: CAD file, 2016-09-06, last stored version]
keyboard/files/Ergodox/ErgoDOX Acrylic Case - Designed by Litster/Standard/Left/ErgoDOX Case Layer 2 Spacer - Left.dxf
202.8 x 177.8 mm
