fkoran/fkoran.github.io/keyboard/files/Ergodox/ErgoDOX Acrylic Case - Designed by Litster/Standard/Right/ErgoDOX Case Layer 5 Bottom - Right.dxf

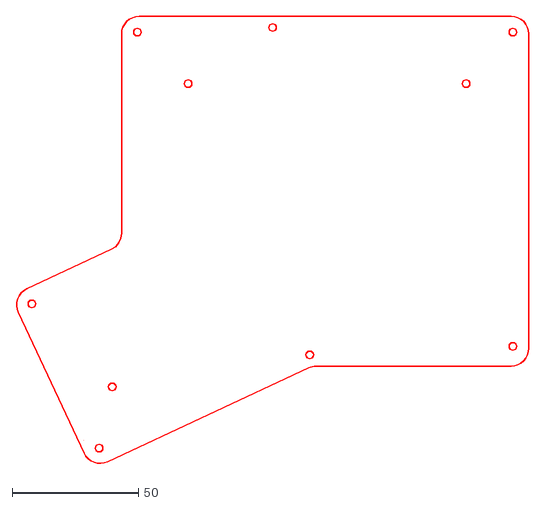
[picture p48: CAD file, 2016-09-06, last stored version]
keyboard/files/Ergodox/ErgoDOX Acrylic Case - Designed by Litster/Standard/Right/ErgoDOX Case Layer 5 Bottom - Right.dxf
202.8 x 177.8
