fkoran/fkoran.github.io/keyboard/files/Ergodox/ErgoDOX Acrylic Case - Designed by Litster/with Wrist Rest/Left/ErgoDOX Wrist Rest Case Layer 1 Top - Left.dxf

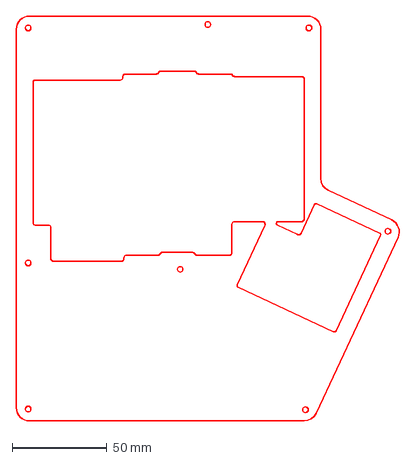
[picture p49: CAD file, 2016-09-06, last stored version]
keyboard/files/Ergodox/ErgoDOX Acrylic Case - Designed by Litster/with Wrist Rest/Left/ErgoDOX Wrist Rest Case Layer 1 Top - Left.dxf
202.8 x 214.1 mm
