fkoran/fkoran.github.io/keyboard/files/Ergodox/ErgoDOX Acrylic Case - Designed by Litster/Standard/Left/ErgoDOX Case Layer 3 Plate - Left.dxf

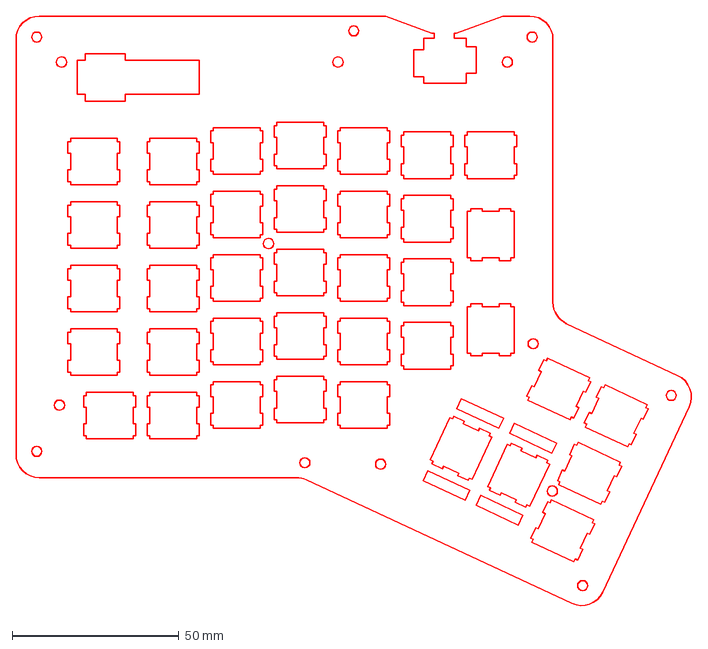
[picture p51: CAD file, 2016-09-06, last stored version]
keyboard/files/Ergodox/ErgoDOX Acrylic Case - Designed by Litster/Standard/Left/ErgoDOX Case Layer 3 Plate - Left.dxf
202.8 x 177.8 mm
