fkoran/fkoran.github.io/images/ergodox/assembly_complete_right_minus_keys_small.jpg

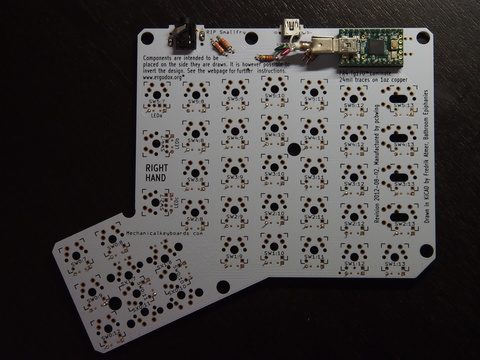
images/ergodox/assembly_complete_right_minus_keys_small.jpg
