fkoran/fkoran.github.io/images/ergodox/assembly_diodes_mashed_alt_small.jpg

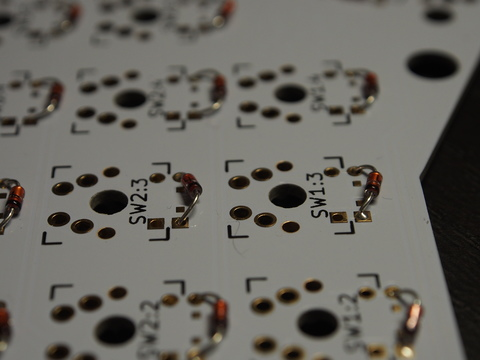
images/ergodox/assembly_diodes_mashed_alt_small.jpg
