fkoran/fkoran.github.io/images/ergodox/assembly_diodes_mashed_small.jpg

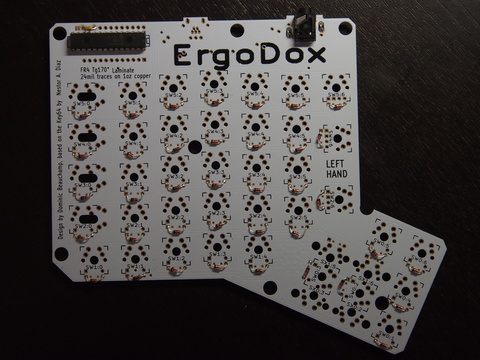
images/ergodox/assembly_diodes_mashed_small.jpg
