fkoran/fkoran.github.io/images/ergodox/assembly_diodes_resistors_soldered.jpg

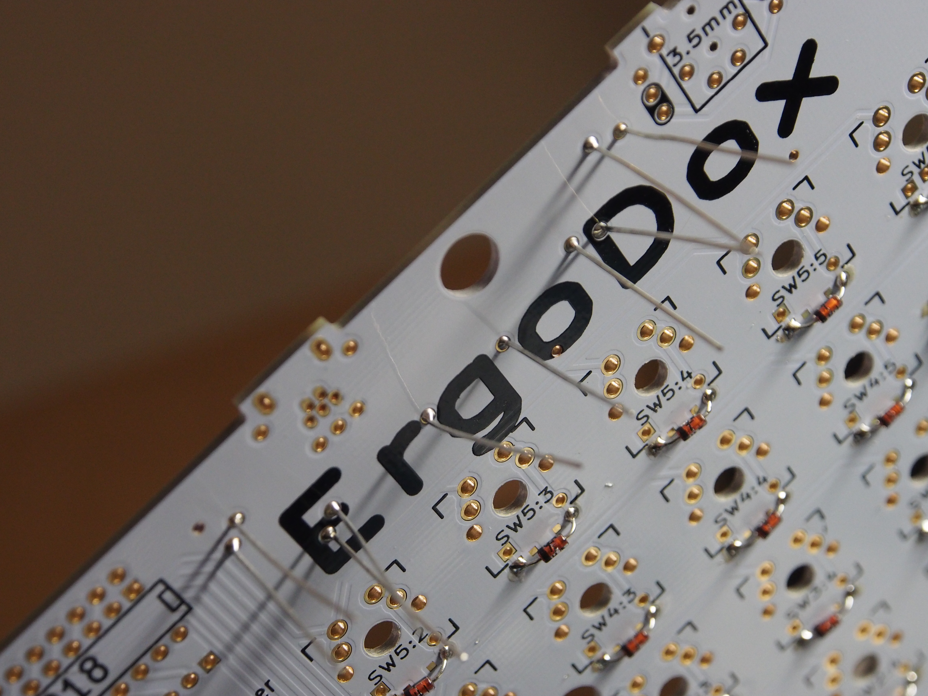
images/ergodox/assembly_diodes_resistors_soldered.jpg
