fkoran/fkoran.github.io/images/ergodox/assembly_diodes_soldered.jpg

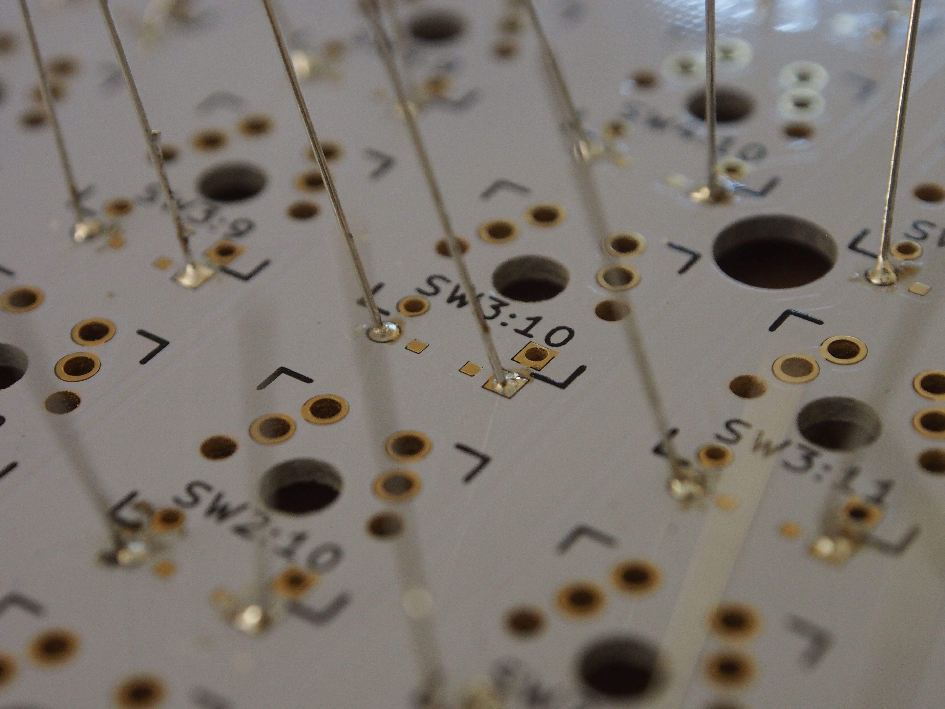
images/ergodox/assembly_diodes_soldered.jpg
