fkoran/fkoran.github.io/images/ergodox/assembly_mcu_pad_small.jpg

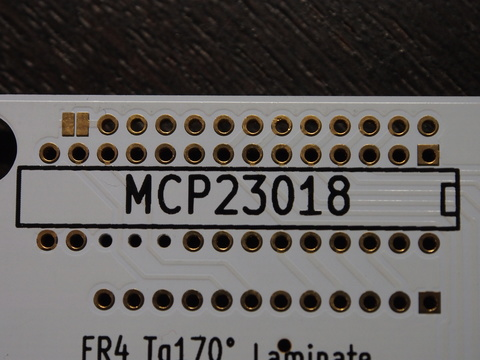
images/ergodox/assembly_mcu_pad_small.jpg
