fkoran/fkoran.github.io/images/ergodox/assembly_resistor_pads.jpg

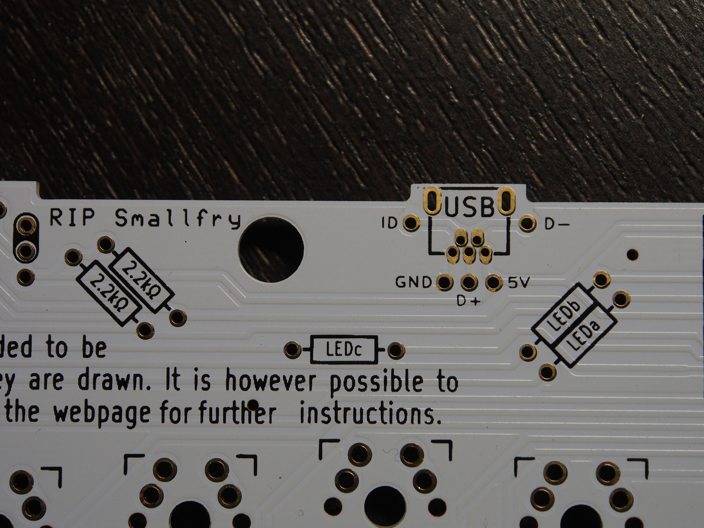
images/ergodox/assembly_resistor_pads.jpg
