fkoran/fkoran.github.io/images/ergodox/assembly_resistor_stuffed.jpg

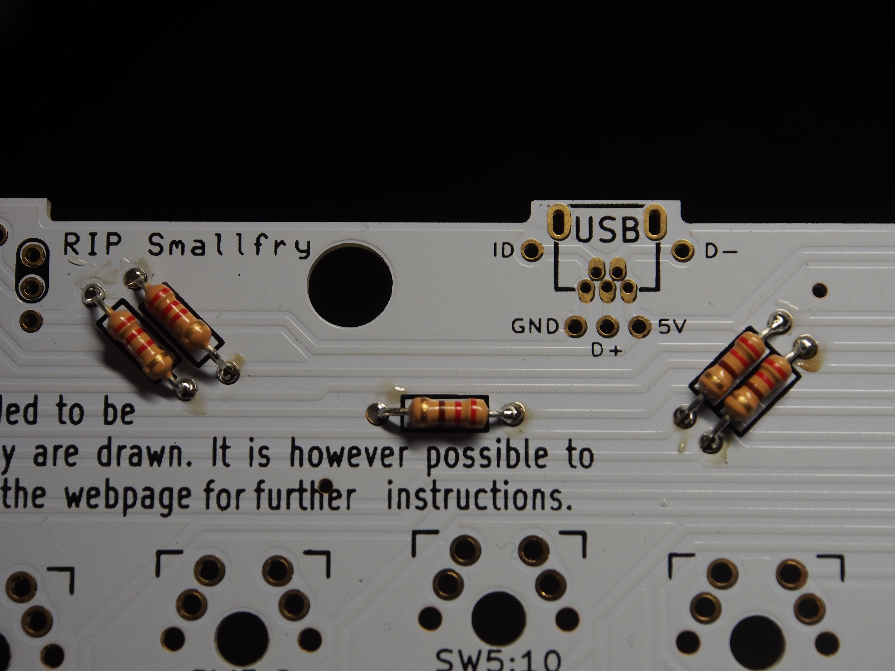
images/ergodox/assembly_resistor_stuffed.jpg
