fkoran/fkoran.github.io/images/ergodox/assembly_usb_0.jpg

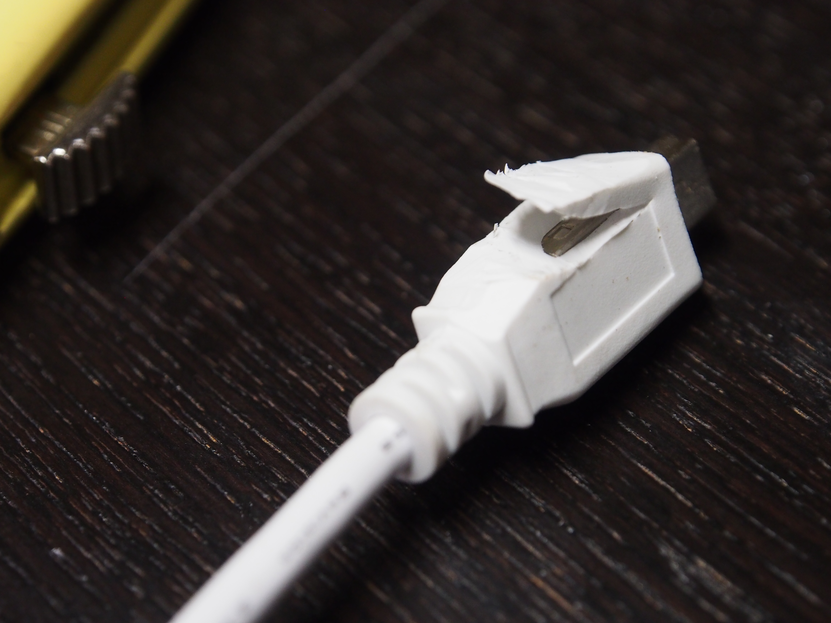
images/ergodox/assembly_usb_0.jpg
