fkoran/fkoran.github.io/images/ergodox/assembly_usb_2.jpg

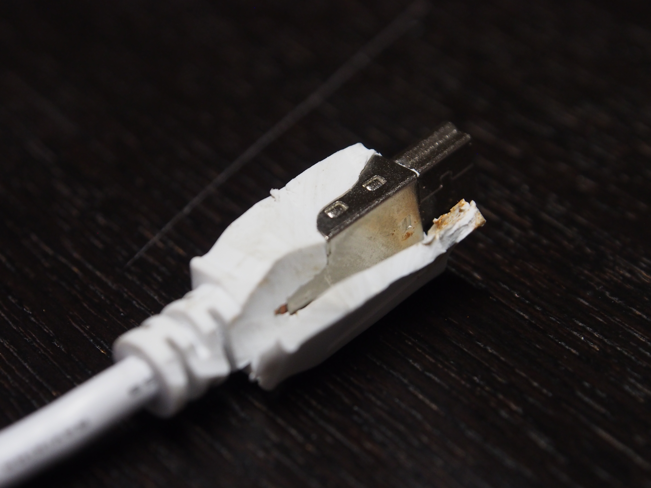
images/ergodox/assembly_usb_2.jpg
