fkoran/fkoran.github.io/images/ergodox/assembly_usb_3.jpg

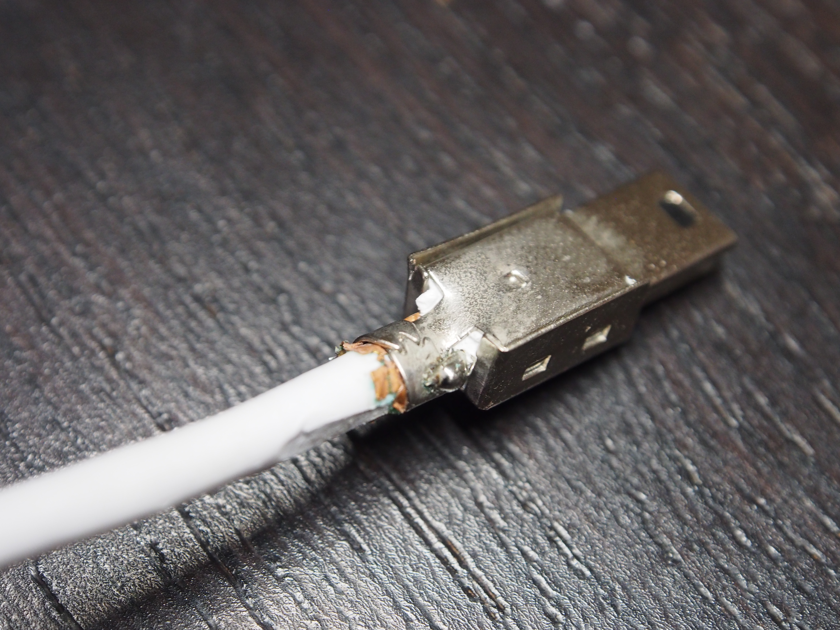
images/ergodox/assembly_usb_3.jpg
