fkoran/fkoran.github.io/images/ergodox/assembly_usb_4.jpg

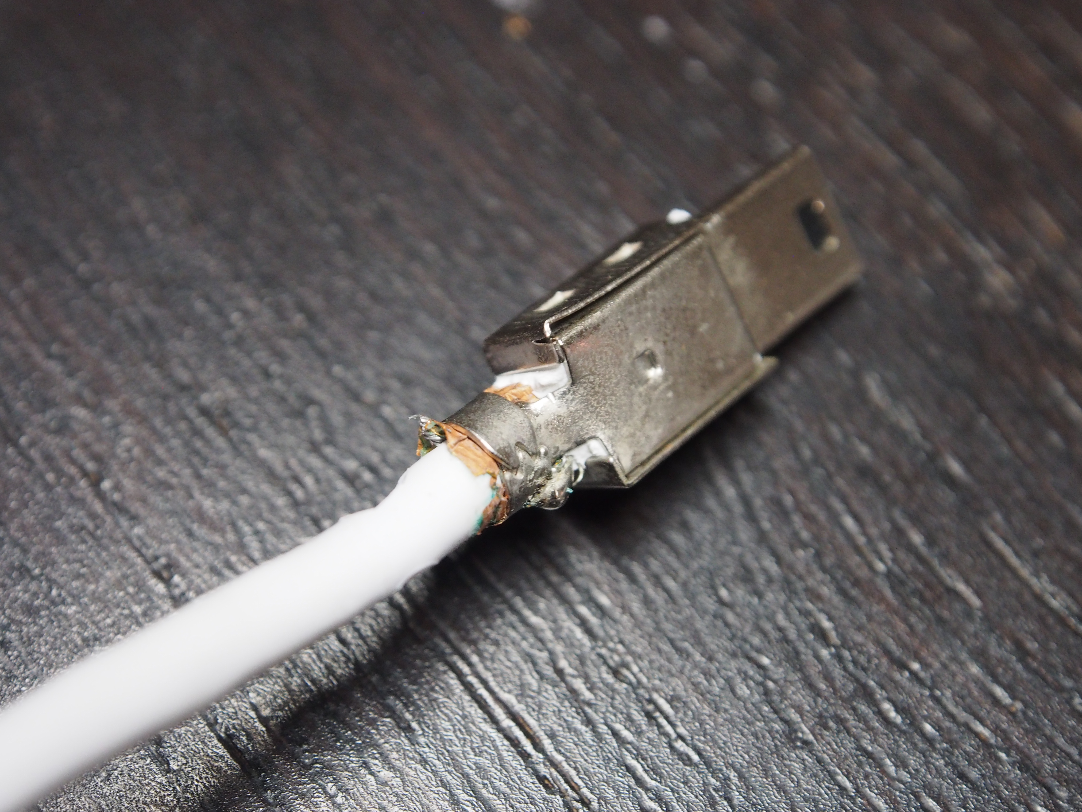
images/ergodox/assembly_usb_4.jpg
