fkoran/fkoran.github.io/images/ergodox/assembly_usb_5.jpg

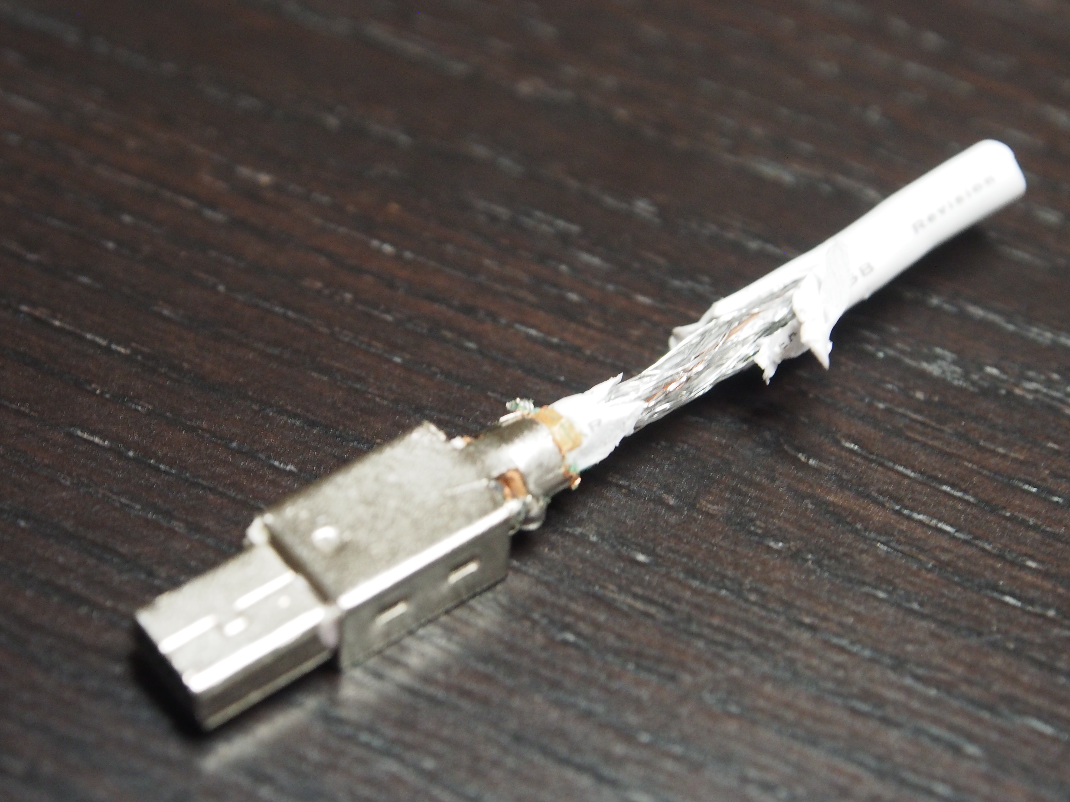
images/ergodox/assembly_usb_5.jpg
