fkoran/fkoran.github.io/images/ergodox/assembly_usb_6.jpg

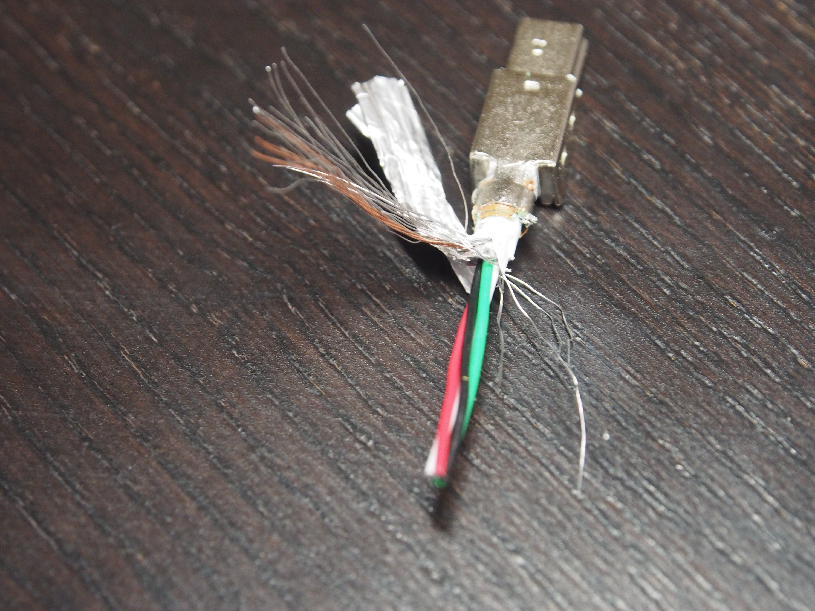
images/ergodox/assembly_usb_6.jpg
