fkoran/fkoran.github.io/images/ergodox/fugly_soldering_2_small.jpg

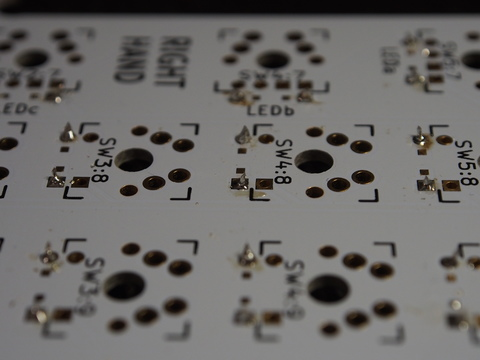
images/ergodox/fugly_soldering_2_small.jpg
