fkoran/fkoran.github.io/images/ergodox/gowri_soldering.jpg

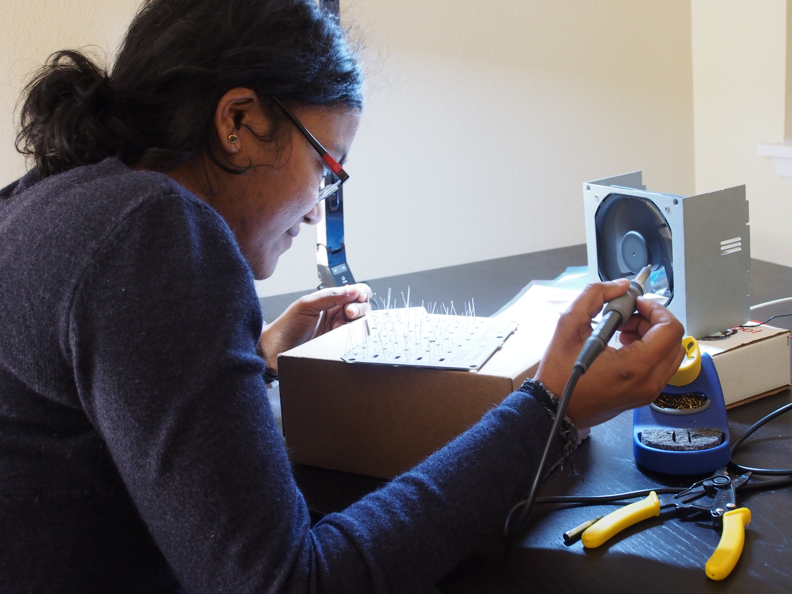
images/ergodox/gowri_soldering.jpg
