fkoran/fkoran.github.io/keyboard/files/ErgoDox_PCB_Designed_by_pbiphany/ErgoDOX20130208/ErgoDOX/ErgoDOX.kicad_pcb

## KiCad design keyboard/files/ErgoDox_PCB_Designed_by_pbiphany/ErgoDOX20130208/ErgoDOX/ErgoDOX.kicad_pcb (2016-09-06, last stored version)

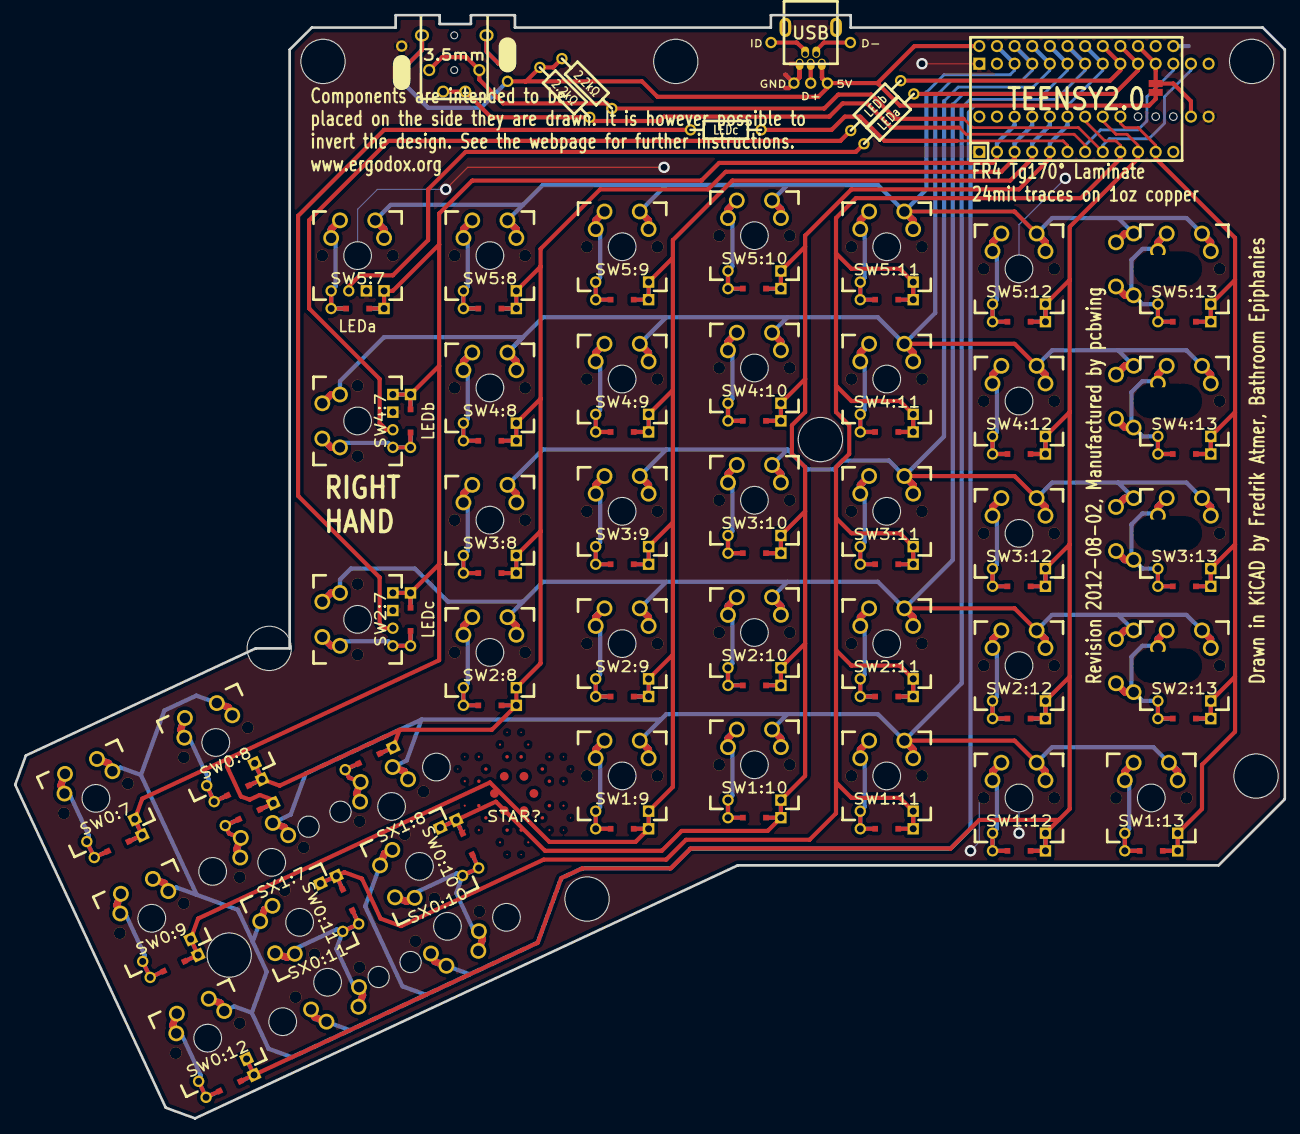
[picture p72: board ErgoDOX.kicad_pcb from above]

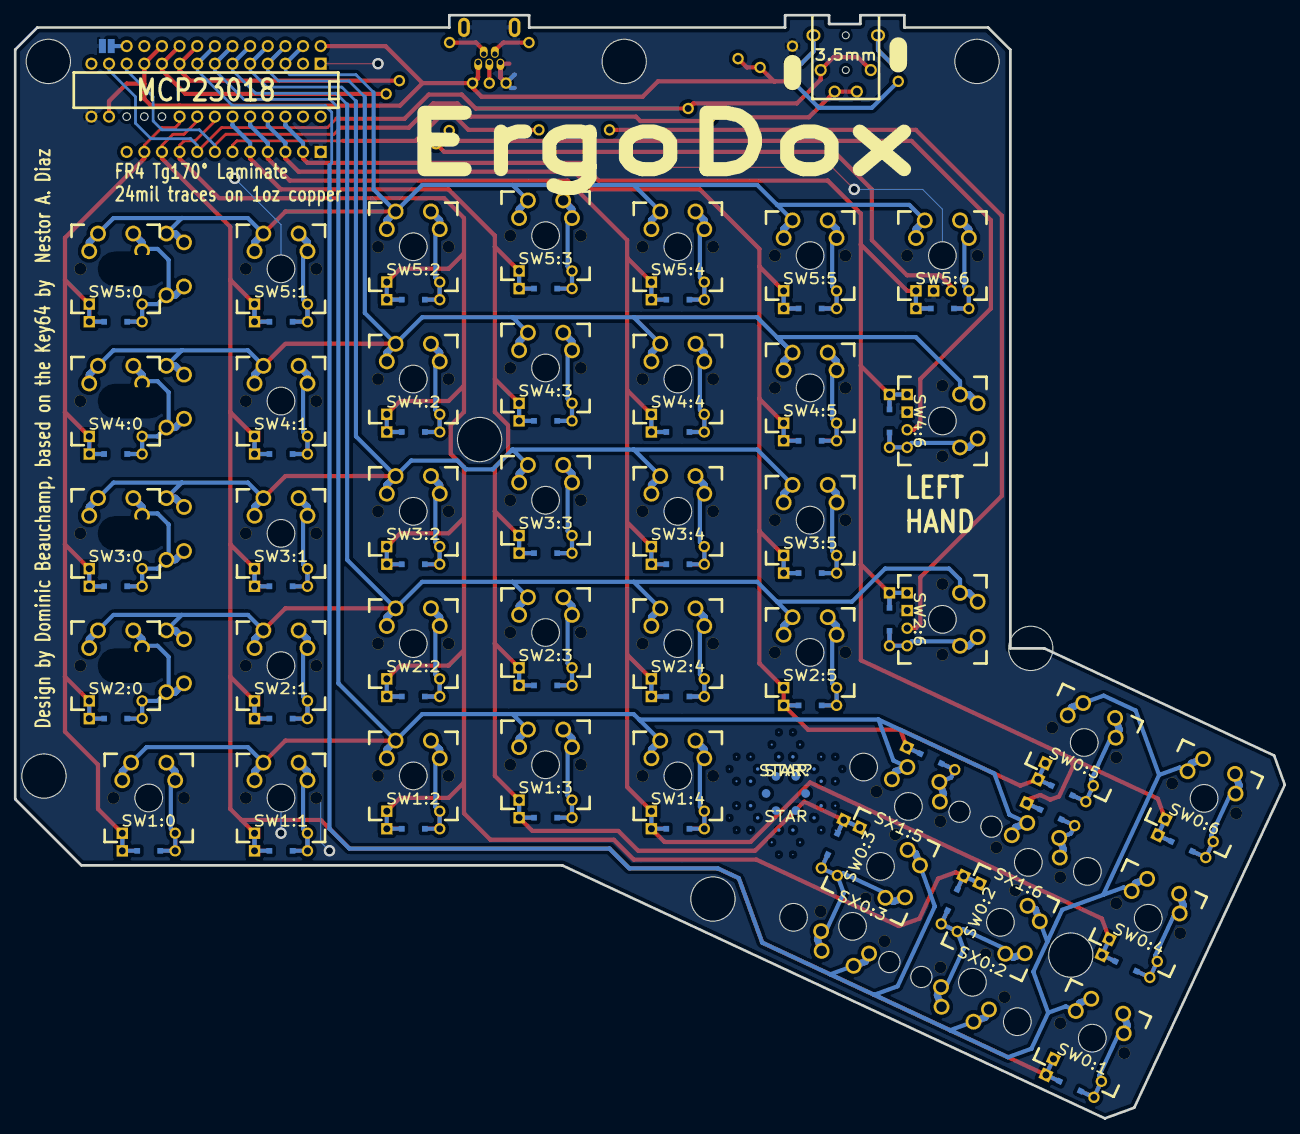
[picture p73: board ErgoDOX.kicad_pcb from below]

Board: 2 copper layers, 182.8 x 158.9 mm, 65 parts (4 on the bottom side), 65 nets.

Parts:
D1:7, D1:8: D; DIODE
H99: MECHANICAL; ErgoDOXmech
J1: USB; USBMINImod
J2: 3.5mm; 4pin35mmAudio
J3, J4: JMP; 100PITCH1X3
JP1, JP2: JUMPER; GAP
LED_A1: LEDa; MX_LED
LED_B1: LEDb; MX_LED
LED_C1: LEDc; MX_LED
R1, R2: 2.2kΩ; RESISTOR
RA1: LEDa; RESISTOR
RB1: LEDb; RESISTOR
RC1: LEDc; RESISTOR
S1, S2: STAB200; STAB_PCB940
STAR?: STAR
STAR?#2: STAR
SW0:7: SW0:6; MX_FLIP_DIODE
SW0:8: SW0:5; MX_FLIP_DIODE
SW0:9: SW0:4; MX_FLIP_DIODE
SW0:10: SW0:3; MX_FLIP_DIODE
SW0:11: SW0:2; MX_FLIP_DIODE
SW0:12: SW0:1; MX_FLIP_DIODE
SW1:9: SW1:4; MX_FLIP_DIODE
SW1:10: SW1:3; MX_FLIP_DIODE
SW1:11: SW1:2; MX_FLIP_DIODE
SW1:12: SW1:1; MX_FLIP_DIODE
SW1:13: SW1:0; MX_FLIP_DIODE
SW2:7: SW2:6; MX_FLIP_DIODE
SW2:8: SW2:5; MX_FLIP_DIODE
SW2:9: SW2:4; MX_FLIP_DIODE
SW2:10: SW2:3; MX_FLIP_DIODE
SW2:11: SW2:2; MX_FLIP_DIODE
SW2:12: SW2:1; MX_FLIP_DIODE
SW2:13: SW2:0; MX_FLIP_XX
SW3:8: SW3:5; MX_FLIP_DIODE
SW3:9: SW3:4; MX_FLIP_DIODE
SW3:10: SW3:3; MX_FLIP_DIODE
SW3:11: SW3:2; MX_FLIP_DIODE
SW3:12: SW3:1; MX_FLIP_DIODE
SW3:13: SW3:0; MX_FLIP_XX
SW4:7: SW4:6; MX_FLIP_DIODE
SW4:8: SW4:5; MX_FLIP_DIODE
SW4:9: SW4:4; MX_FLIP_DIODE
SW4:10: SW4:3; MX_FLIP_DIODE
SW4:11: SW4:2; MX_FLIP_DIODE
SW4:12: SW4:1; MX_FLIP_DIODE
SW4:13: SW4:0; MX_FLIP_XX
SW5:7: SW5:6; MX_FLIP_DIODE
SW5:8: SW5:5; MX_FLIP_DIODE
SW5:9: SW5:4; MX_FLIP_DIODE
SW5:10: SW5:3; MX_FLIP_DIODE
SW5:11: SW5:2; MX_FLIP_DIODE
SW5:12: SW5:1; MX_FLIP_DIODE
SW5:13: SW5:0; MX_FLIP_XX
SX0:10: SX0:3; MX_FLIP
SX0:11: SX0:2; MX_FLIP
SX1:7: SX1:6; MX_FLIP
SX1:8: SX1:5; MX_FLIP
U1: TEENSY2.0; TEENSY_2.0
U2: MCP23018; DIP28_300

Connections:
/COL0: SW1:13.4, SW2:13.4, SW3:13.4, SW4:13.4, SW5:13.4, U1.11, U2.20
/COL1: SW0:12.4, SW1:12.4, SW2:12.4, SW3:12.4, SW4:12.4, SW5:12.4, U1.10, U2.21
/COL4: SW0:9.4, SW1:9.4, SW2:9.4, SW3:9.4, SW4:9.4, SW5:9.4, U1.4, U2.24
/COL5: D1:8.2, SW0:8.4, SW2:8.4, SW3:8.4, SW4:8.4, SW5:8.4, U1.3, U2.25
/COL6: D1:7.2, SW0:7.4, SW2:7.4, SW4:7.4, SW5:7.4, U1.2, U2.26
/COL10: SW0:10.4, SW1:10.4, SW2:10.4, SW3:10.4, SW4:10.4, SW5:10.4, U1.5, U2.23
/COL11: SW0:11.4, SW1:11.4, SW2:11.4, SW3:11.4, SW4:11.4, SW5:11.4, U1.9, U2.22
/LED_A: RA1.1, U1.21
/LED_B: RB1.1, U1.22
/LED_C: RC1.1, U1.6
/ROW0: SW0:7.1, SW0:8.1, SW0:9.1, SW0:10.1, SW0:11.1, SW0:12.1, SX0:10.1, SX0:11.1, U1.23, U2.8
/ROW1: SW1:9.1, SW1:10.1, SW1:11.1, SW1:12.1, SW1:13.1, SX1:7.1, SX1:8.1, U1.24, U2.7
/ROW2: SW2:7.1, SW2:8.1, SW2:9.1, SW2:10.1, SW2:11.1, SW2:12.1, SW2:13.1, U1.25, U2.6
/ROW3: SW3:8.1, SW3:9.1, SW3:10.1, SW3:11.1, SW3:12.1, SW3:13.1, U1.26, U2.5
/ROW4: SW4:7.1, SW4:8.1, SW4:9.1, SW4:10.1, SW4:11.1, SW4:12.1, SW4:13.1, U1.27, U2.4
/ROW5: SW5:7.1, SW5:8.1, SW5:9.1, SW5:10.1, SW5:11.1, SW5:12.1, SW5:13.1, U1.28, U2.3
/SCLM: J2.3, J2.5, R2.2, U1.7, U2.12
/SDAM: J2.2, J2.6, R1.2, U1.8, U2.13
GND: H99.0, J1.5, J1.6, J3.3, J4.3, JP2.1, LED_A1.2, LED_B1.2, LED_C1.2, S1.0, S2.0, SW0:7.0, SW0:8.0, SW0:9.0, SW0:10.0, SW0:11.0, SW0:12.0, SW1:9.0, SW1:10.0, SW1:11.0, SW1:12.0, SW1:13.0, SW2:7.0, SW2:8.0, SW2:9.0, SW2:10.0, SW2:11.0, SW2:12.0, SW2:13.0, SW3:8.0, SW3:9.0, SW3:10.0, SW3:11.0, SW3:12.0, SW3:13.0, SW4:7.0, SW4:8.0, SW4:9.0, SW4:10.0, SW4:11.0, SW4:12.0, SW4:13.0, SW5:7.0, SW5:8.0, SW5:9.0, SW5:10.0, SW5:11.0, SW5:12.0, SW5:13.0, SX0:10.0, SX0:11.0, SX1:7.0, SX1:8.0, U1.1, U1.18, U2.1, U2.15
unnamed: J2.4, J4.2
unnamed: J2.1, J3.2
unnamed: SW5:12.2, SW5:12.3
unnamed: SW5:8.2, SW5:8.3
unnamed: SW5:7.2, SW5:7.3
unnamed: D1:8.1, SX1:8.2
unnamed: SW5:9.2, SW5:9.3
unnamed: SW5:10.2, SW5:10.3
unnamed: SW5:11.2, SW5:11.3
unnamed: SW1:9.2, SW1:9.3
unnamed: SW0:10.2, SW0:10.3, SX0:10.2
unnamed: D1:7.1, SX1:7.2
unnamed: SW2:10.2, SW2:10.3
unnamed: SW3:9.2, SW3:9.3
unnamed: SW3:8.2, SW3:8.3
unnamed: SW2:7.2, SW2:7.3
unnamed: SW2:8.2, SW2:8.3
unnamed: SW2:9.2, SW2:9.3
unnamed: SW2:11.2, SW2:11.3
unnamed: SW1:11.2, SW1:11.3
unnamed: SW1:10.2, SW1:10.3
unnamed: SW2:12.2, SW2:12.3
unnamed: SW5:13.2, SW5:13.3
unnamed: SW4:9.2, SW4:9.3
unnamed: SW4:11.2, SW4:11.3
unnamed: SW4:12.2, SW4:12.3
unnamed: SW2:13.2, SW2:13.3
unnamed: SW4:13.2, SW4:13.3
unnamed: SW3:13.2, SW3:13.3
unnamed: SW3:12.2, SW3:12.3
unnamed: SW3:11.2, SW3:11.3
unnamed: SW3:10.2, SW3:10.3
unnamed: SW0:8.2, SW0:8.3
unnamed: SW1:13.2, SW1:13.3
unnamed: SW1:12.2, SW1:12.3
unnamed: SW0:12.2, SW0:12.3
unnamed: SW0:9.2, SW0:9.3
unnamed: SW0:7.2, SW0:7.3
unnamed: SW4:7.2, SW4:7.3
unnamed: SW4:8.2, SW4:8.3
unnamed: SW4:10.2, SW4:10.3
unnamed: LED_C1.1, RC1.2
unnamed: LED_B1.1, RB1.2
unnamed: LED_A1.1, RA1.2
unnamed: SW0:11.2, SW0:11.3, SX0:11.2
VCC: J1.1, J3.1, J4.1, JP1.1, R1.1, R2.1, U1.20, U1.29, U2.11, U2.16
