fkoran/fkoran.github.io/(commit log)

2016-09-06 ergodox build log
    [$ErgoDOX.sch, ErgoDOX Case Layer 1 Top - Left.dxf, ErgoDOX Case Layer 1 Top - Right.dxf, ErgoDOX Case Layer 2 Spacer - Left.dxf, ErgoDOX Case Layer 2 Spacer - Right - filled.svg_5mm.stl, ErgoDOX Case Layer 2 Spacer - Right.dxf, ErgoDOX Case Layer 3 Plate - Left.dxf, ErgoDOX Case Layer 3 Plate - Right.dxf]
2016-11-10 expand center flow
